Orlandogani/pers-esp32-headset/README.txt

This project is for custom headset Electronics PCB Routing. The name is coming from the acronym of my own name.

ORGA: Omni Radiant Gaming Apparatus
Vibe & Product Fit: Flagship RGB peripherals—think high-end wireless mice and master-class headsets designed for professional esports athletes who demand absolute dominance.
