Orlandogani/pers-esp32-headset/mech/out/V0_report_A.md

# ORGA rev A — V0 check report

Generated by `src/build_all.py`. Geometry checked with OpenCascade in the build workspace.

## Interference (all printed parts + purchased envelopes, assembly pose)

**Zero unintended overlaps.** (Press-fit inserts and the antenna region inside the module are excluded on purpose.)

## Clearance: left outer shell to each envelope [mm]

| Envelope | Distance | Rule (≥ 0.5 FDM) |
|---|---|---|
| arm pivot screw | 0.00 | CHECK |
| J1 USB-C | 0.09 | intended back-stop (0.1) |
| J4 jack | 0.10 | intended back-stop (0.1) |
| SW3 wheel | 0.30 | OK (wheel slot gap ≥ 0.25) |
| PCB | 0.30 | OK (PCB pocket rule ≥ 0.3) |
| D7+D3 LEDs | 0.91 | OK |
| U2 module | 2.03 | OK |
| SW PWR | 2.47 | OK |
| SW MFB | 2.50 | OK |
| MK1 | 2.56 | OK |
| MK2 | 2.56 | OK |
| SW3 encoder body | 2.85 | OK |
| driver L | 7.12 | OK |
| driver L magnet | 10.68 | OK |

Cell swell envelope to right outer shell: **2.15 mm** · driver to PCB: **1.20 mm** (vent gap ≥ 1.0)

## Antenna keep-out (≥ 15 mm to metal)

| Metal item | Distance [mm] | Result |
|---|---|---|
| screw pcb 2 | 15.6 | OK |
| insert pcb 2 | 15.7 | OK |
| driver L magnet | 16.7 | OK |
| MK2 | 18.2 | OK |
| insert shell 1 | 20.5 | OK |
| screw shell 1 | 22.9 | OK |
| SW MFB | 28.3 | OK |
| SW3 encoder body | 38.4 | OK |

## Cup tilt vs arm (rotation about the arm pivot axis)

| Tilt [deg] | Worst overlap [mm³] |
|---|---|
| -7.0 | 0.00 |
| -3.5 | 0.00 |
| +3.5 | 0.00 |
| +7.0 | 0.00 |

## Assembly-motion checks (rev A.5)

Each part is moved along its real assembly path; the table gives the worst overlap with anything it meets (0 = free path).

**Close left shell onto frame + PCB (travel along the cup axis)**

| Distance to go / offset | Worst overlap [mm³] | Between |
|---|---|---|
| 22 | 0.00 | — |
| 16 | 0.00 | — |
| 11 | 0.00 | — |
| 7 | 0.00 | — |
| 4 | 0.00 | — |
| 2 | 0.00 | — |
| 1 | 0.00 | — |
| 0.3 | 0.00 | — |

**Close right shell onto frame + driver + cell**

| Distance to go / offset | Worst overlap [mm³] | Between |
|---|---|---|
| 22 | 0.00 | — |
| 16 | 0.00 | — |
| 11 | 0.00 | — |
| 7 | 0.00 | — |
| 4 | 0.00 | — |
| 2 | 0.00 | — |
| 1 | 0.00 | — |
| 0.3 | 0.00 | — |

**Arm into the left shell tunnel (from the open side)**

| Distance to go / offset | Worst overlap [mm³] | Between |
|---|---|---|
| 25 | 0.00 | — |
| 18 | 0.00 | — |
| 12 | 0.00 | — |
| 8 | 0.00 | — |
| 5 | 0.00 | — |
| 3 | 0.00 | — |
| 1.5 | 0.00 | — |
| 0.5 | 0.00 | — |

**Pad ring into the skirt (snap: small overlap while the bumps pass is intended)**

| Distance to go / offset | Worst overlap [mm³] | Between |
|---|---|---|
| 7 | 0.00 | — |
| 5 | 0.00 | — |
| 4.6 | 1.69 | PADRING-L / CUPL-FRM |
| 4.2 | 5.72 | PADRING-L / CUPL-FRM |
| 3 | 5.93 | PADRING-L / CUPL-FRM |
| 2 | 5.93 | PADRING-L / CUPL-FRM |
| 1 | 5.16 | PADRING-L / CUPL-FRM |
| 0.3 | 0.00 | — |
| 0 | 0.00 | — |

**Slider in BAND-TOP (+ = pulled out; detent and stop contact expected)**

| Distance to go / offset | Worst overlap [mm³] | Between |
|---|---|---|
| 14 | 0.00 | — |
| 10 | 0.00 | — |
| 8 | 0.00 | — |
| 7 | 0.00 | — |
| 6.6 | 0.48 | SLIDER-L / BAND-TOP |
| 6.3 | 0.07 | SLIDER-L / BAND-TOP |
| 6.1 | 0.00 | — |
| 5.1 | 0.48 | SLIDER-L / BAND-TOP |
| 4.1 | 0.00 | — |
| 3 | 0.48 | SLIDER-L / BAND-TOP |
| 2 | 0.00 | — |
| 1 | 0.48 | SLIDER-L / BAND-TOP |
| 0 | 0.00 | — |
| -1 | 0.48 | SLIDER-L / BAND-TOP |
| -2 | 0.00 | — |
| -4.1 | 0.00 | — |
| -6.1 | 0.00 | — |

**Tool access**

| Tool path | Overlap [mm³] | Min clearance [mm] |
|---|---|---|
| shell screw 1: Ø3 bit from the ear side | 0.00 | 0.70 |
| shell screw 2: Ø3 bit from the ear side | 0.00 | 0.70 |
| shell screw 3: Ø3 bit from the ear side | 0.00 | 0.70 |
| shell screw 4: Ø3 bit from the ear side | 0.00 | 0.70 |
| PCB screw 1: Ø3 bit from above | 0.00 | 4.95 |
| PCB screw 2: Ø3 bit from above | 0.00 | 9.96 |
| PCB screw 3: Ø3 bit from above | 0.00 | 10.85 |
| arm pivot screw: Ø6 driver from outside | 0.00 | 0.78 |
| pivot nut: Ø6 tweezers along the screw axis from the cavity | 0.00 | 0.32 |

## Mass (PETG 1.27 g/cm³ × 0.9 fill; bought parts assumed)

| Item | g |
|---|---|
| CUPL-OUT | 34.4 |
| CUPL-FRM | 24.1 |
| CUPR-OUT | 34.9 |
| CUPR-FRM | 26.3 |
| PADRING-L | 6.0 |
| PADRING-R | 6.0 |
| KEY-PWR | 0.1 |
| KEY-MFB | 0.1 |
| LGUIDE | 0.2 |
| ARM-L | 4.2 |
| ARM-R | 4.2 |
| SLIDER-L | 3.7 |
| SLIDER-R | 3.7 |
| BAND-TOP | 35.4 |
| driver L (bought) | 12 |
| driver R (bought) | 12 |
| PCB assembly (bought) | 10 |
| cell 603450 (bought) | 20 |
| ear pad L (bought) | 12.5 |
| ear pad R (bought) | 12.5 |
| steel band 175x12x1 (bought) | 16.5 |
| screws + inserts (bought) | 3 |
| screws + inserts R (bought) | 2 |
| harness (bought) | 5 |
| cushion foam (bought) | 5 |

**Left cup 110 g · right cup 122 g · headband 62 g · total 294 g** (MR-001 ≤ 300: OK; MR-002 L/R Δ 11 g ≤ 40: OK)

## Print bed fit (256 × 256 × 256)

| Part | Print bbox [mm] | Fits |
|---|---|---|
| CUPL-OUT | 78 × 105 × 22 | yes |
| CUPL-FRM | 78 × 105 × 29 | yes |
| CUPR-OUT | 78 × 105 × 22 | yes |
| CUPR-FRM | 78 × 105 × 31 | yes |
| PADRING-L | 80 × 107 × 8 | yes |
| PADRING-R | 80 × 107 × 8 | yes |
| KEY-PWR | 8 × 4 × 6 | yes |
| KEY-MFB | 8 × 4 × 6 | yes |
| LGUIDE | 4 × 7 × 8 | yes |
| ARM-L | 41 × 84 × 8 | yes |
| ARM-R | 41 × 84 × 8 | yes |
| SLIDER-L | 60 × 67 × 12 | yes |
| SLIDER-R | 60 × 67 × 12 | yes |
| BAND-TOP | 190 × 42 × 26 | yes |

## Edge-part alignment

Shell openings are generated from the same layout table as the PCB change list, so offsets are 0.0 mm by construction. The real check runs when the updated KiCad board STEP comes back (file 09 round-trip).
