Orlandogani/pers-esp32-headset/mech/out/V0_report_B.md

# ORGA rev B — V0 check report

Generated by `src/build_all.py`. Geometry checked with OpenCascade in the build workspace.

## Interference (all printed parts + purchased envelopes, assembly pose)

**Zero unintended overlaps.** (Press-fit inserts and the antenna region inside the module are excluded on purpose.)

## Clearance: left outer shell to each envelope [mm]

| Envelope | Distance | Rule (≥ 0.5 FDM) |
|---|---|---|
| J1 USB-C | 0.09 | intended back-stop (0.1) |
| J4 jack | 0.10 | intended back-stop (0.1) |
| SW3 wheel | 0.30 | OK (wheel slot gap ≥ 0.25) |
| PCB | 0.30 | OK (PCB pocket rule ≥ 0.3) |
| D7+D3 LEDs | 0.91 | OK |
| U2 module | 2.03 | OK |
| SW PWR | 2.47 | OK |
| SW MFB | 2.50 | OK |
| MK1 | 2.56 | OK |
| MK2 | 2.56 | OK |
| SW3 encoder body | 2.85 | OK |
| driver L | 8.48 | OK |
| driver L magnet | 10.68 | OK |

Cell swell envelope to right outer shell: **2.15 mm** · driver to PCB: **1.20 mm** (vent gap ≥ 1.0)

## Antenna keep-out (≥ 15 mm to metal)

| Metal item | Distance [mm] | Result |
|---|---|---|
| screw pcb 2 | 15.6 | OK |
| insert pcb 2 | 15.7 | OK |
| driver L magnet | 16.7 | OK |
| MK2 | 18.2 | OK |
| insert shell 1 | 20.5 | OK |
| screw shell 1 | 22.9 | OK |
| SW MFB | 28.3 | OK |
| SW3 encoder body | 38.4 | OK |

## Cup tilt vs yoke (rotation about the stud axis)

Doc 06 asks ±10° free. Contact past ±12° is the intended hard stop (stud lug in the yoke-end arc slot).

| Tilt [deg] | Worst overlap [mm³] |
|---|---|
| -14.0 | 6.43 |
| -12.5 | 0.18 |
| -11.5 | 0.00 |
| -10.0 | 0.00 |
| -5.0 | 0.00 |
| +5.0 | 0.00 |
| +10.0 | 0.00 |
| +11.5 | 0.00 |
| +12.5 | 0.18 |
| +14.0 | 0.71 |

## Swivel (yaw) vs slider collar and S-arm

| Yaw [deg] | Worst overlap [mm³] | Between |
|---|---|---|
| -15.0 | 0.00 | — |
| -7.5 | 0.00 | — |
| +7.5 | 0.00 | — |
| +15.0 | 0.00 | — |

## Yoke snap-on (hand calculation, PETG E ≈ 2 GPa)

Each end spreads **4.4 mm** to pass its stud: ≈ **4.4 N** per end, peak bending stress ≈ **13 MPa** (PETG yield ≈ 50 MPa). VERIFY on the first print.

## Assembly-motion checks (rev B)

Each part is moved along its real assembly path; the table gives the worst overlap with anything it meets (0 = free path).

**Close left shell onto frame + PCB (travel along the cup axis)**

| Distance to go / offset | Worst overlap [mm³] | Between |
|---|---|---|
| 22 | 0.00 | — |
| 16 | 0.00 | — |
| 11 | 0.00 | — |
| 7 | 0.00 | — |
| 4 | 0.00 | — |
| 2 | 0.00 | — |
| 1 | 0.00 | — |
| 0.3 | 0.00 | — |

**Close right shell onto frame + driver + cell**

| Distance to go / offset | Worst overlap [mm³] | Between |
|---|---|---|
| 22 | 0.00 | — |
| 16 | 0.00 | — |
| 11 | 0.00 | — |
| 7 | 0.00 | — |
| 4 | 0.00 | — |
| 2 | 0.00 | — |
| 1 | 0.00 | — |
| 0.3 | 0.00 | — |

**Yoke lowered onto the closed left cup: everything except the stud zones (the ends spread 4.4 mm over the studs, see snap calc)**

| Distance to go / offset | Worst overlap [mm³] | Between |
|---|---|---|
| 8 | 0.00 | — |
| 5 | 0.00 | — |
| 3 | 0.00 | — |
| 1.5 | 0.00 | — |
| 0.5 | 0.00 | — |
| 0 | 0.00 | — |

**Slider collar down over the yoke's swivel pin**

| Distance to go / offset | Worst overlap [mm³] | Between |
|---|---|---|
| 8 | 0.00 | — |
| 5 | 0.00 | — |
| 3 | 0.00 | — |
| 1 | 0.00 | — |
| 0.3 | 0.00 | — |
| 0 | 0.00 | — |

**Pad ring into the skirt (snap: small overlap while the bumps pass is intended)**

| Distance to go / offset | Worst overlap [mm³] | Between |
|---|---|---|
| 7 | 0.00 | — |
| 5 | 0.00 | — |
| 4.6 | 1.69 | PADRING-L / CUPL-FRM |
| 4.2 | 5.72 | PADRING-L / CUPL-FRM |
| 3 | 5.93 | PADRING-L / CUPL-FRM |
| 2 | 5.93 | PADRING-L / CUPL-FRM |
| 1 | 5.16 | PADRING-L / CUPL-FRM |
| 0.3 | 0.00 | — |
| 0 | 0.00 | — |

**Slider in BAND-TOP (+ = pulled out; detent and stop contact expected)**

| Distance to go / offset | Worst overlap [mm³] | Between |
|---|---|---|
| 14 | 0.00 | — |
| 10 | 0.00 | — |
| 8 | 0.00 | — |
| 7 | 0.00 | — |
| 6.6 | 0.48 | SLIDER-L / BAND-TOP |
| 6.3 | 0.07 | SLIDER-L / BAND-TOP |
| 6.1 | 0.00 | — |
| 5.1 | 0.48 | SLIDER-L / BAND-TOP |
| 4.1 | 0.00 | — |
| 3 | 0.48 | SLIDER-L / BAND-TOP |
| 2 | 0.00 | — |
| 1 | 0.48 | SLIDER-L / BAND-TOP |
| 0 | 0.00 | — |
| -1 | 0.48 | SLIDER-L / BAND-TOP |
| -2 | 0.00 | — |
| -4.1 | 0.00 | — |
| -6.1 | 0.00 | — |

**Tool access**

| Tool path | Overlap [mm³] | Min clearance [mm] |
|---|---|---|
| shell screw 1: Ø3 bit from the ear side | 0.00 | 0.70 |
| shell screw 2: Ø3 bit from the ear side | 0.00 | 0.70 |
| shell screw 3: Ø3 bit from the ear side | 0.00 | 0.70 |
| shell screw 4: Ø3 bit from the ear side | 0.00 | 0.70 |
| PCB screw 1: Ø3 bit from above | 0.00 | 4.95 |
| PCB screw 2: Ø3 bit from above | 0.00 | 9.96 |
| PCB screw 3: Ø3 bit from above | 0.00 | 10.85 |
| collar set screw: Ø3 bit from the -X_H side | 0.00 | 0.30 |

## Mass (PETG 1.27 g/cm³ × 0.9 fill; bought parts assumed)

| Item | g |
|---|---|
| CUPL-OUT | 31.0 |
| CUPL-FRM | 24.3 |
| CUPR-OUT | 31.5 |
| CUPR-FRM | 26.5 |
| PADRING-L | 6.0 |
| PADRING-R | 6.0 |
| KEY-PWR | 0.1 |
| KEY-MFB | 0.1 |
| LGUIDE | 0.2 |
| YOKE-L | 6.6 |
| YOKE-R | 6.6 |
| SLIDER-L | 4.8 |
| SLIDER-R | 4.8 |
| BAND-TOP | 35.4 |
| driver L (bought) | 12 |
| driver R (bought) | 12 |
| PCB assembly (bought) | 10 |
| cell 603450 (bought) | 20 |
| ear pad L (bought) | 12.5 |
| ear pad R (bought) | 12.5 |
| steel band 175x12x1 (bought) | 16.5 |
| screws + inserts (bought) | 3 |
| screws + inserts R (bought) | 2 |
| harness (bought) | 5 |
| cushion foam (bought) | 5 |

**Left cup 111 g · right cup 122 g · headband 62 g · total 294 g** (MR-001 ≤ 300: OK; MR-002 L/R Δ 11 g ≤ 40: OK)

## Print bed fit (256 × 256 × 256)

| Part | Print bbox [mm] | Fits |
|---|---|---|
| CUPL-OUT | 86 × 105 × 22 | yes |
| CUPL-FRM | 78 × 105 × 29 | yes |
| CUPR-OUT | 86 × 105 × 22 | yes |
| CUPR-FRM | 78 × 105 × 31 | yes |
| PADRING-L | 80 × 107 × 8 | yes |
| PADRING-R | 80 × 107 × 8 | yes |
| KEY-PWR | 8 × 4 × 6 | yes |
| KEY-MFB | 8 × 4 × 6 | yes |
| LGUIDE | 4 × 7 × 8 | yes |
| YOKE-L | 86 × 73 × 13 | yes |
| YOKE-R | 86 × 73 × 13 | yes |
| SLIDER-L | 60 × 80 × 12 | yes |
| SLIDER-R | 60 × 80 × 12 | yes |
| BAND-TOP | 190 × 42 × 26 | yes |

## Edge-part alignment

Shell openings are generated from the same layout table as the PCB change list, so offsets are 0.0 mm by construction. The real check runs when the updated KiCad board STEP comes back (file 09 round-trip).
