Orlandogani/pers-esp32-headset/mech/log.md

# Mechanical iteration log

| Date | Rev | Change | Print / result |
|---|---|---|---|
| 2026-10-08 | baseline | MDCP v0.1 issued; board envelope from orga-v1 placement | — |
| 2026-10-09 | concept v0 | Decisions: M1-A (components face outer shell), concept C2 (cell in right cup, 5-wire harness). Yoke: plastic fork (confirmed). New issues I-12 (board outline must follow cavity; antenna to magnet) and I-13 (95th-pct ear clearance). Sony WH-1000XM5 reference STEP checked: exterior-only model. | concepts/report.txt, renders/ORGA-concept-C*.png |
| 2026-10-09 | A | Rev A fit-test build: 15 printed parts (cups L/R outer + frame, pad rings, keys, wheel, light guide, forks, sliders, band top). V0: 0 interferences, clearances OK, antenna >= 17.5 mm, tilt +/-10 deg clear, all parts fit 256 bed. Mass est. 301 g (MR-001 at limit, bought masses assumed). PCB package: out/ORGA-PCB-outline-A.dxf + out/PCB_changes_A.md. | out/V0_report_A.md, renders/ORGA-M-*-A_*.png |
| 2026-10-09 | A.1 | FORK-L/R changed from rectangular to an oval arch following the cup outline (same superellipse, 6 x 7 mm section, harness channel along the rear arm). Rechecked in FreeCAD via MCP: 0 interferences, tilt +/-10 deg clear. Fork 10.7 -> 8.7 g each; total est. 297 g (MR-001 now OK). | renders/ORGA-M-ASM-A1_freecad_*.png |
| 2026-10-09 | A.2 | All edge parts moved to the lower half of the rim (front->rear: jack, POWER, USB-C, wheel, MFB), all sitting directly on the PCB, openings in one band 0.7-2.5 mm above the board. Thumbwheel = Panasonic EVQ-WK edge-drive (Ø15, H 3.5, VERIFY availability); printed WHEEL part removed (moved to out/_obsolete). Lower shell screws moved to rim gaps; MK1 to (-17,-35). Built in workspace, checked in FreeCAD via MCP: 0 interferences, wheel slot gap 0.3, antenna >= 17.5. Mass est. 296 g. | renders/ORGA-M-CUPL-A2_freecad_*.png, out/PCB_changes_A.md |
| 2026-10-09 | A.3 | Fork replaced by a Sony-style single arm (own geometry, not the Sony part): arm enters the top-front rim and runs down a sealed tunnel along the front wall to a tilt pivot at cup centre height (M3 shoulder screw through the front wall into an insert). Tilt +/-7 deg (doc asks 10, VERIFY on head). ESP32 module rotated 90 deg, antenna at the REAR board edge (X=33); LED, MK2, PCB holes 2-3 and upper shell screws moved. Driver frame now assumed plastic, magnet metal (VERIFY). Checked in FreeCAD via MCP: 0 interferences, tilt +/-7 clear, antenna >= 15.6 mm. Mass est. 295 g. Old fork files in out/_obsolete. | renders/ORGA-M-A3_freecad_*.png, out/PCB_changes_A.md |
| 2026-10-09 | A.4 | Assembly pass. Fixes: USB-C and wheel openings now notches open at the shell bottom edge + frame tabs fill them (shell could not be lowered over the PCB); arm tunnel open to the frame (arm drops in; baffle + foam strip = floor); arm notch open at bottom; pivot = ISO 7379 shoulder screw into a pressed M3 nut (nut trap, boss 3.2); PADRING with 6 snap bumps on slit tabs + skirt groove + pry notch, pad sleeve wraps the lip; slider detent with square pull-out stop at +15.7 mm and tip lead-in; arc groove on swivel pin = +/-15 deg yaw stop; Ø2 cross pin closes the steel-band slot; harness grooves on arm, socket, slider. New assembly-motion + tool-access checks all pass (also re-checked shell path and interference in FreeCAD via MCP). Guide: docs/ASSEMBLY.md + renders/ORGA-guide-*.png. Mass est. 294 g. | out/V0_report_A.md |
| 2026-10-10 | A.5 | Routing-chat changes: SW3 = SIQ-02FVS3 (dial Ø14.4, top 4.0 above board; dial t 2.5 / body 1.5 assumed-VERIFY, body 11.1 x 10); PCB tab under the dial 8 mm wide to 4.0 past the dial centre along -62° (ends 0.3 into the wall notch, 3.3 to the notch sides); frame wheel plug pocketed for the tab (0.3 gap, open upward); H1 moved (7,-42) -> (0,-37) (standoff 3.6 to J1, screw-1 tool clearance 4.95). All V0 + assembly-motion checks pass, 0 interferences, mass 294 g. | out/V0_report_A.md, out/PCB_changes_A.md, out/ORGA-PCB-outline-A.dxf |
| 2026-10-13 | B | HS35-style mechanism (own geometry), from the routing chat. The tunnel arm is replaced by a horseshoe YOKE outside the upper half of the cup: plastic snap studs front + rear at y=0 (no metal near the antenna), tilt ±10° free with a hard stop at ±12° (stud lug in an arc slot), swivel collar at the yoke crown (±15°), and an S-arm at the slider end. Harness runs as a free loop to a grommet hole in the outer face. Cap-disc ring groove Ø56 on the outer face. Tunnel, pivot screw and nut removed; board outline +487 mm² along the front-upper wall, edge parts and holes unchanged. Yoke proud 4.1 / 6.1 mm (a flush yoke would need U2 moved ~4 mm). V0: 0 interferences, tilt/yaw/assembly sweeps clear, antenna ≥ 16.7 mm, mass 294 g. | out/V0_report_B.md, renders/ORGA-M-CUPL-B_*.png, out/ORGA-PCB-outline-B.dxf |
