Orlandogani/pers-esp32-headset/mech/renders/ORGA-concept-C1.png

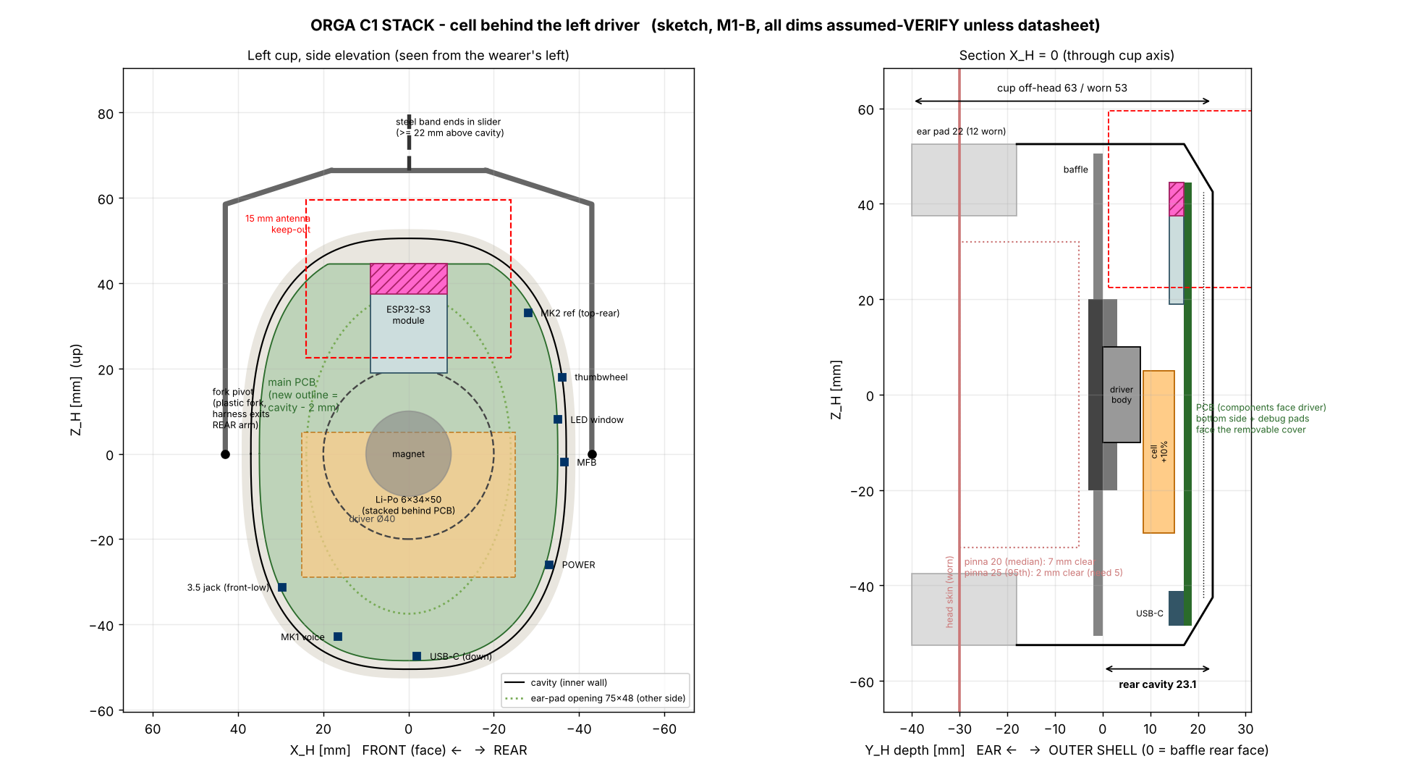
mech/renders/ORGA-concept-C1.png
