Orlandogani/pers-esp32-headset/mech/renders/ORGA-M-A3_freecad_front.png

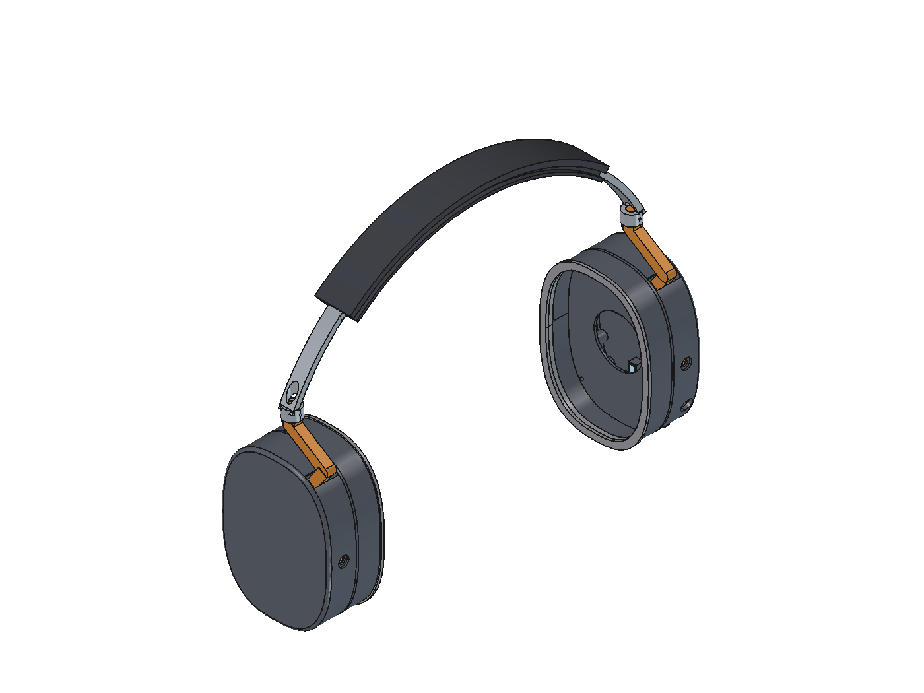
mech/renders/ORGA-M-A3_freecad_front.png
