Orlandogani/pers-esp32-headset/mech/renders/ORGA-M-A3_freecad_xray.png

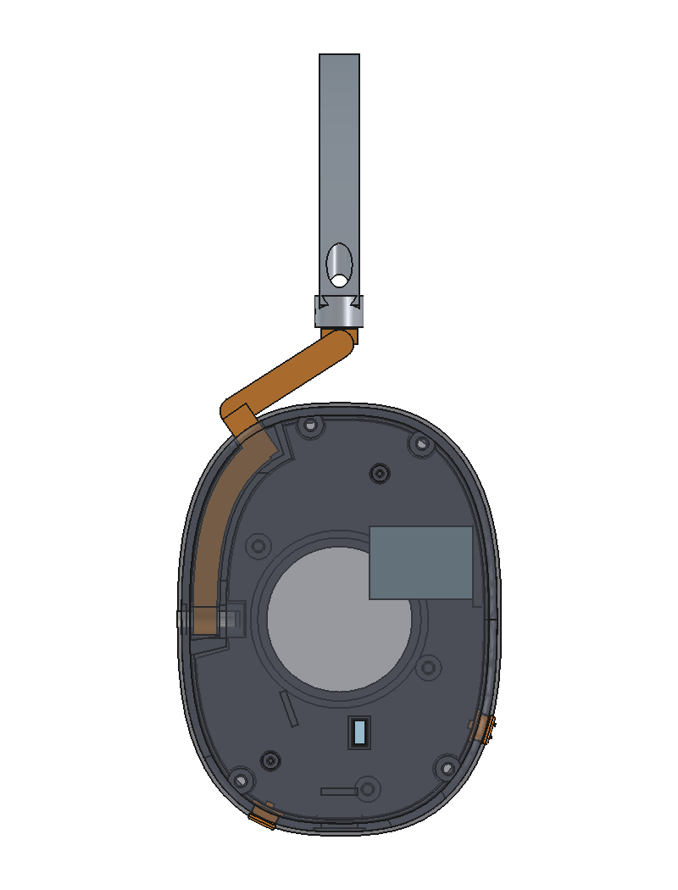
mech/renders/ORGA-M-A3_freecad_xray.png
