Orlandogani/pers-esp32-headset/mech/renders/ORGA-M-A4_freecad_iso.png

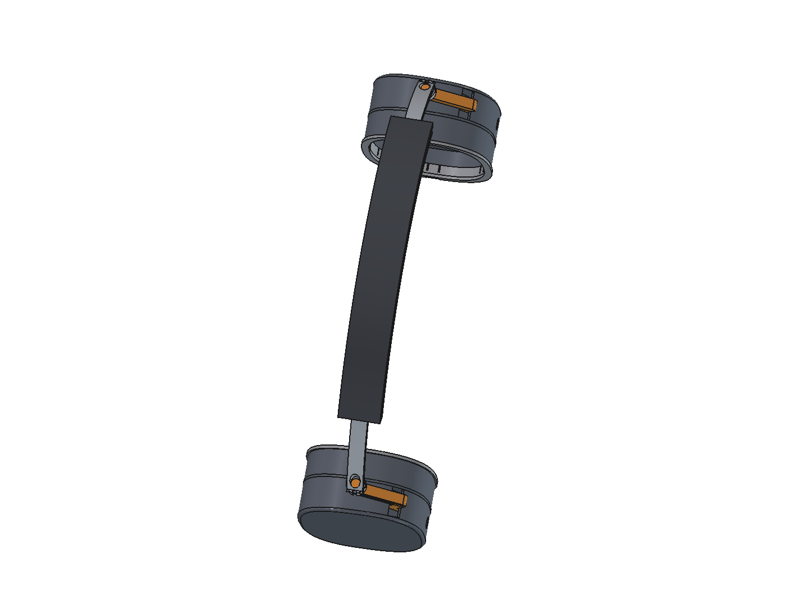
mech/renders/ORGA-M-A4_freecad_iso.png
