Orlandogani/pers-esp32-headset/mech/renders/ORGA-M-ASM-A1_freecad_iso.png

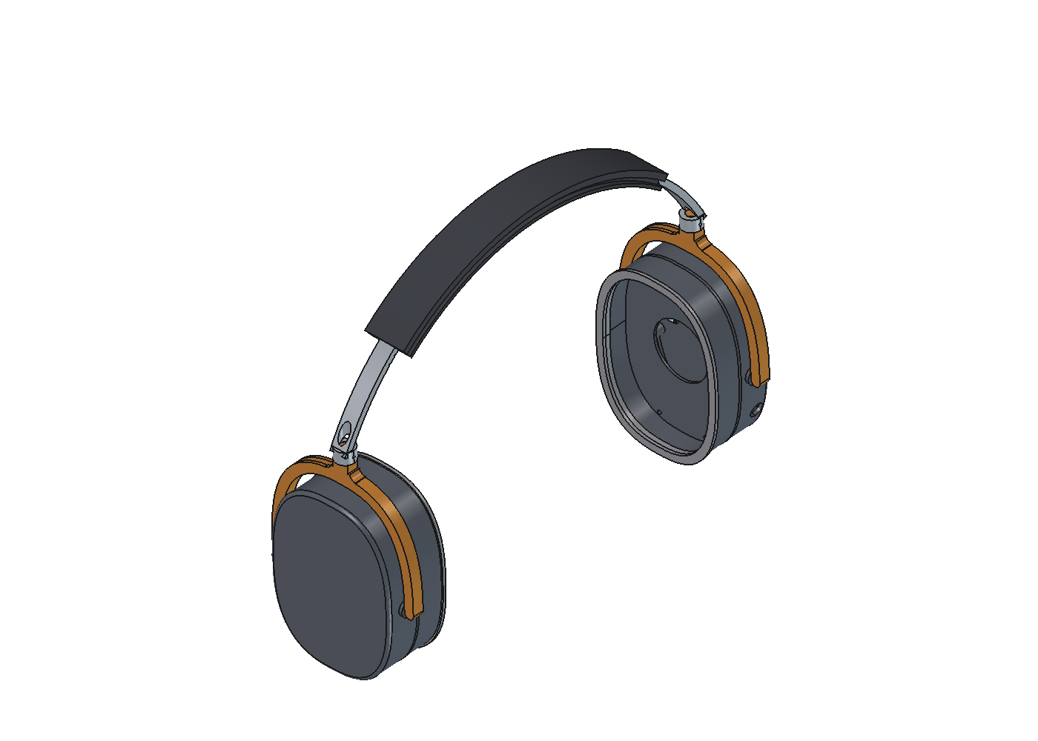
mech/renders/ORGA-M-ASM-A1_freecad_iso.png
