Orlandogani/pers-esp32-headset/mech/renders/ORGA-M-ASM-A1_freecad_side.png

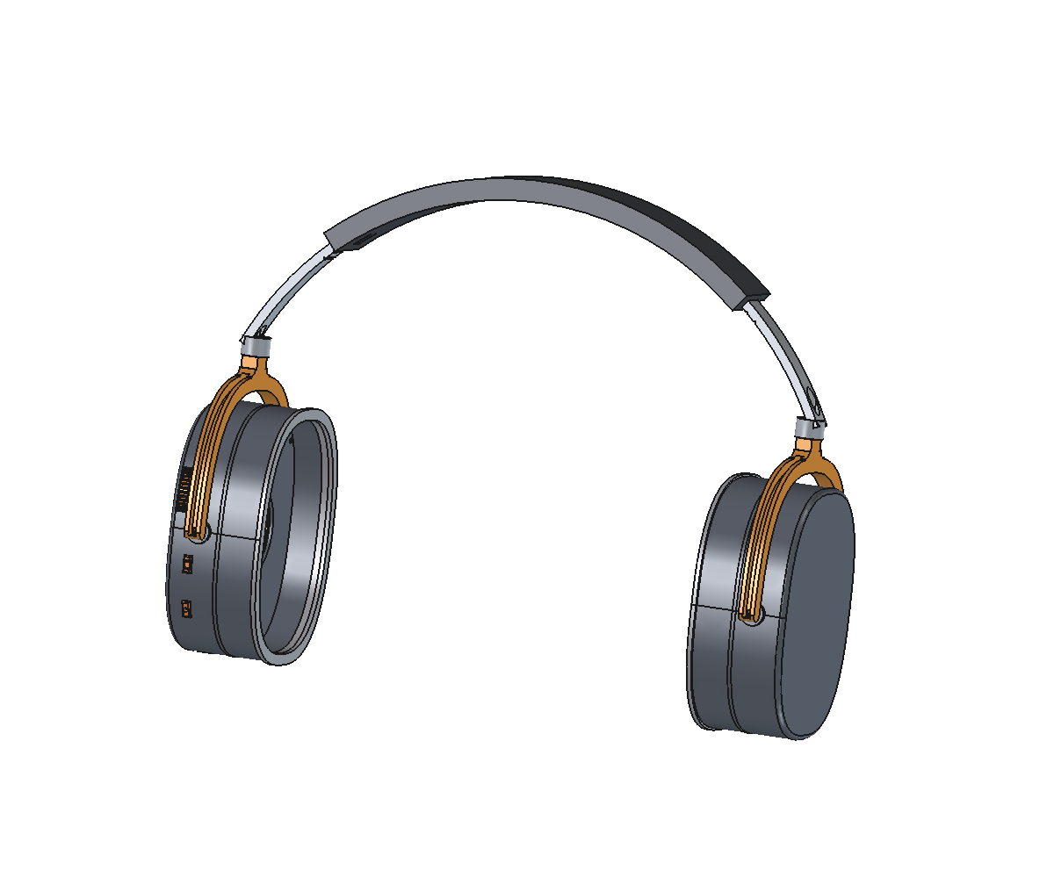
mech/renders/ORGA-M-ASM-A1_freecad_side.png
