Orlandogani/pers-esp32-headset/mech/renders/ORGA-M-ASM-A2_freecad_iso.png

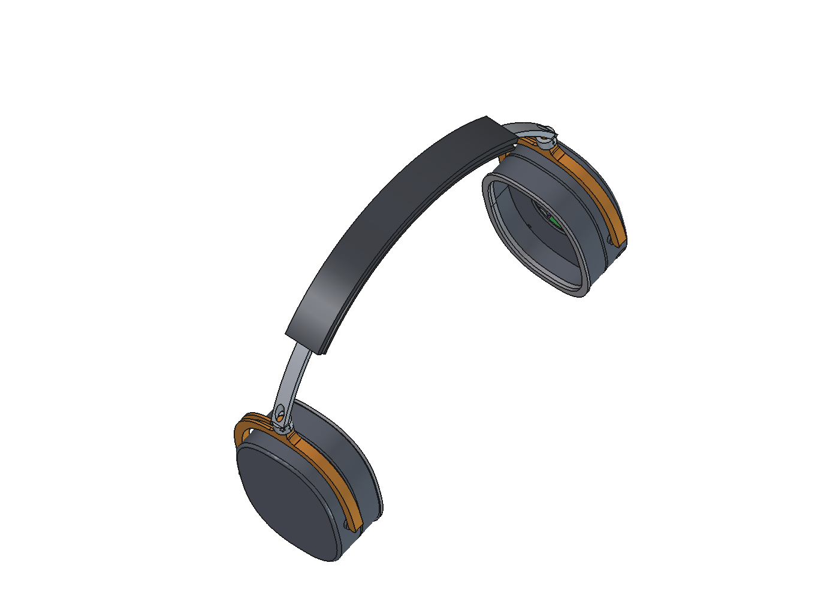
mech/renders/ORGA-M-ASM-A2_freecad_iso.png
