Orlandogani/pers-esp32-headset/mech/renders/ORGA-M-ASM-A_iso.png

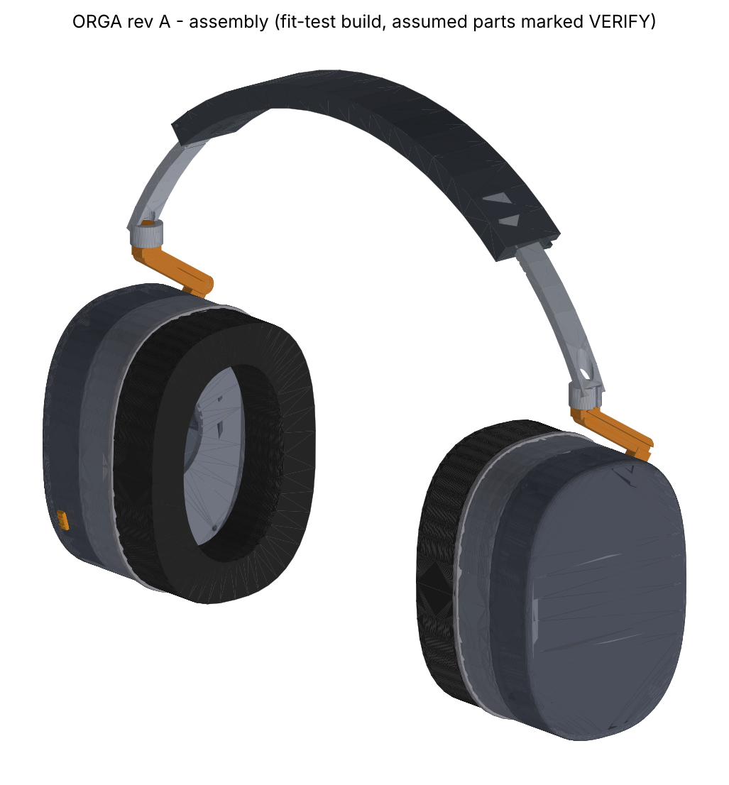
mech/renders/ORGA-M-ASM-A_iso.png
