Orlandogani/pers-esp32-headset/mech/renders/ORGA-M-ASM-B_iso.png

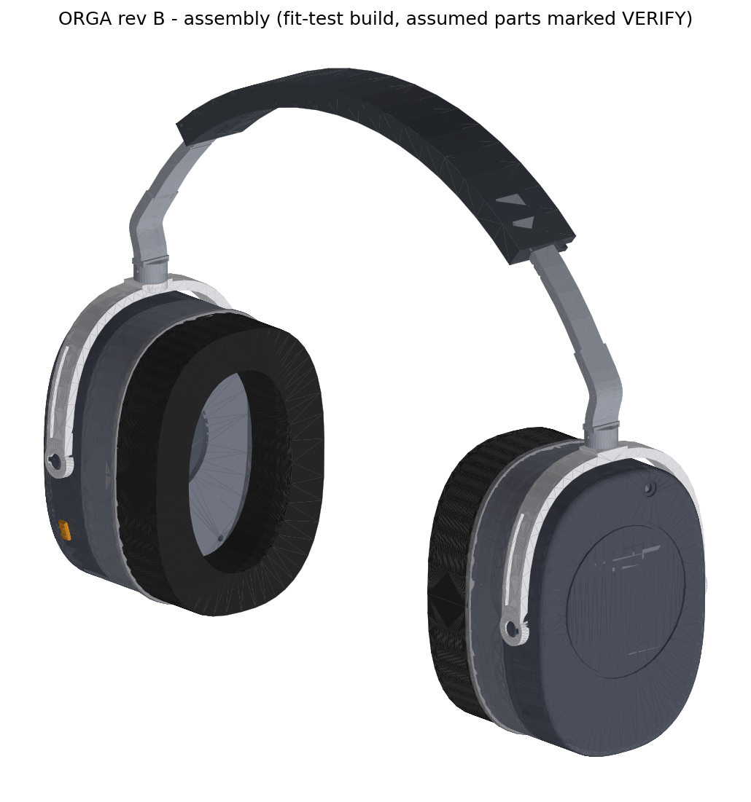
mech/renders/ORGA-M-ASM-B_iso.png
