Orlandogani/pers-esp32-headset/mech/renders/ORGA-M-CUPL-A2_freecad_below.png

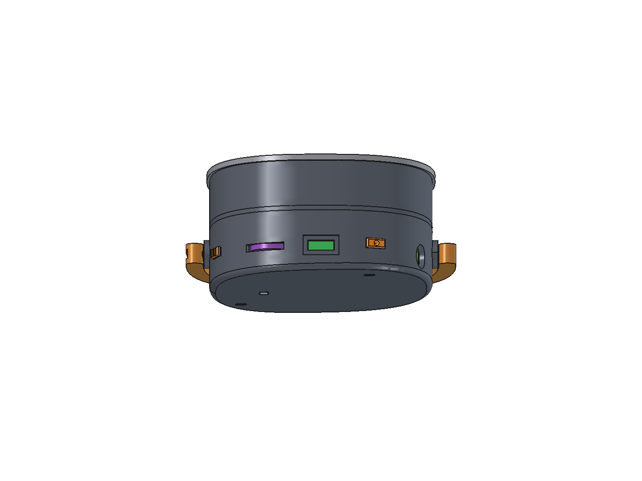
mech/renders/ORGA-M-CUPL-A2_freecad_below.png
