Orlandogani/pers-esp32-headset/mech/renders/ORGA-M-CUPL-A2_freecad_bottom.png

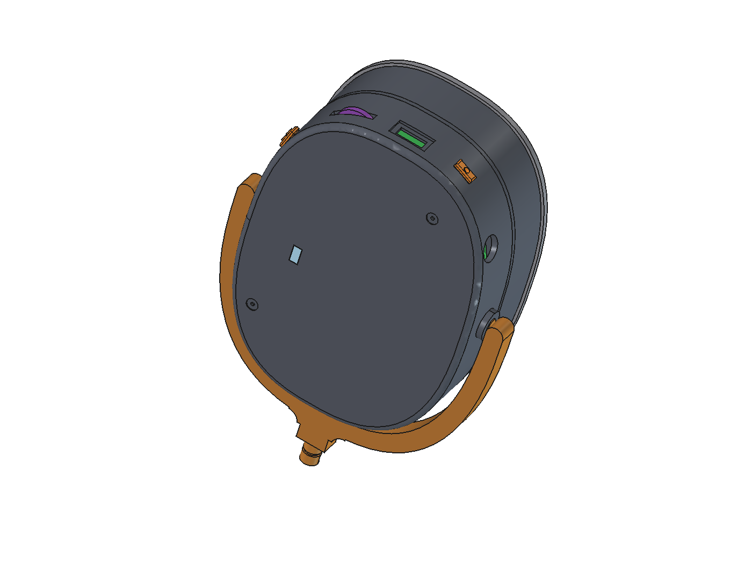
mech/renders/ORGA-M-CUPL-A2_freecad_bottom.png
