Orlandogani/pers-esp32-headset/mech/renders/ORGA-M-CUPL-A2_freecad_side.png

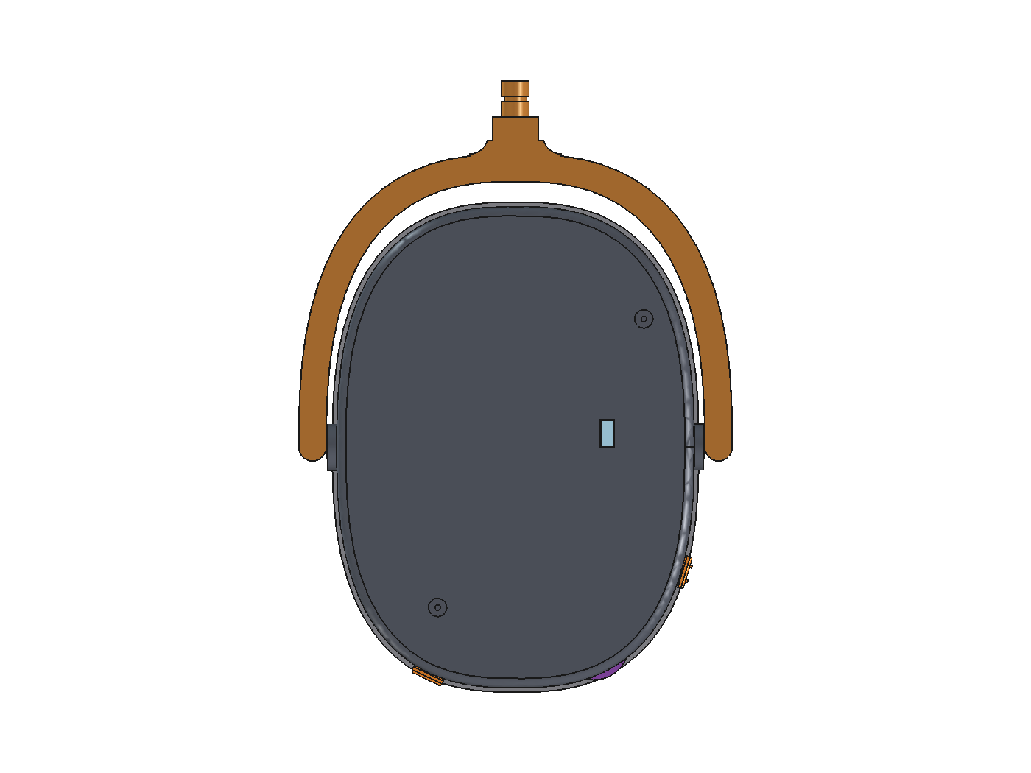
mech/renders/ORGA-M-CUPL-A2_freecad_side.png
