Orlandogani/pers-esp32-headset/mech/renders/ORGA-M-CUPL-A_exploded.png

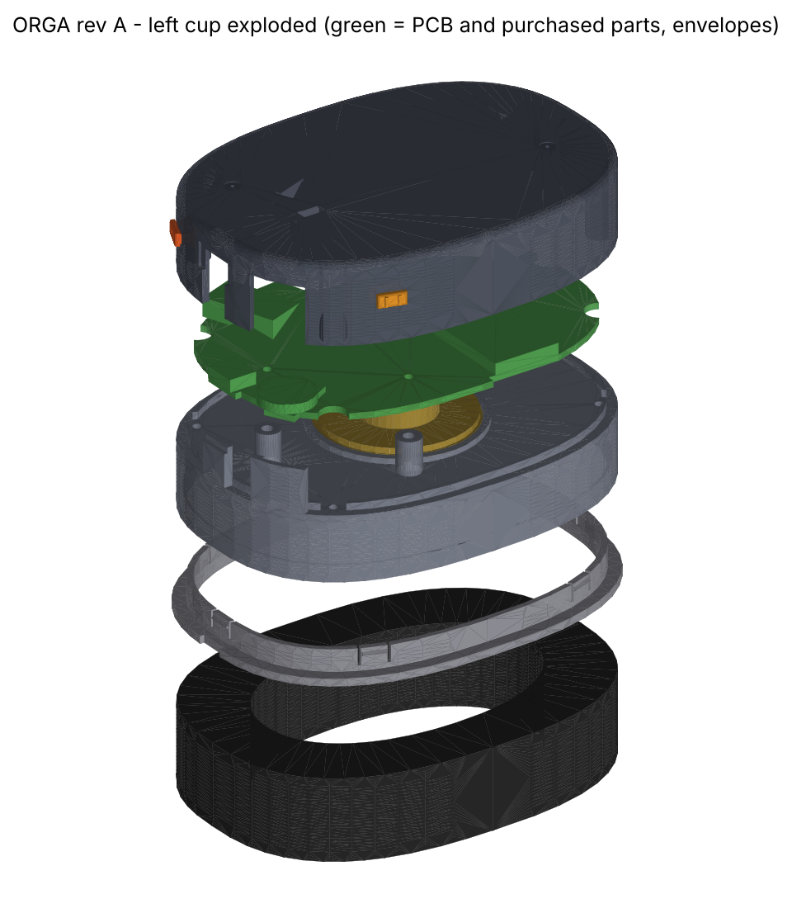
mech/renders/ORGA-M-CUPL-A_exploded.png
