Orlandogani/pers-esp32-headset/mech/renders/ORGA-M-CUPL-A_section.png

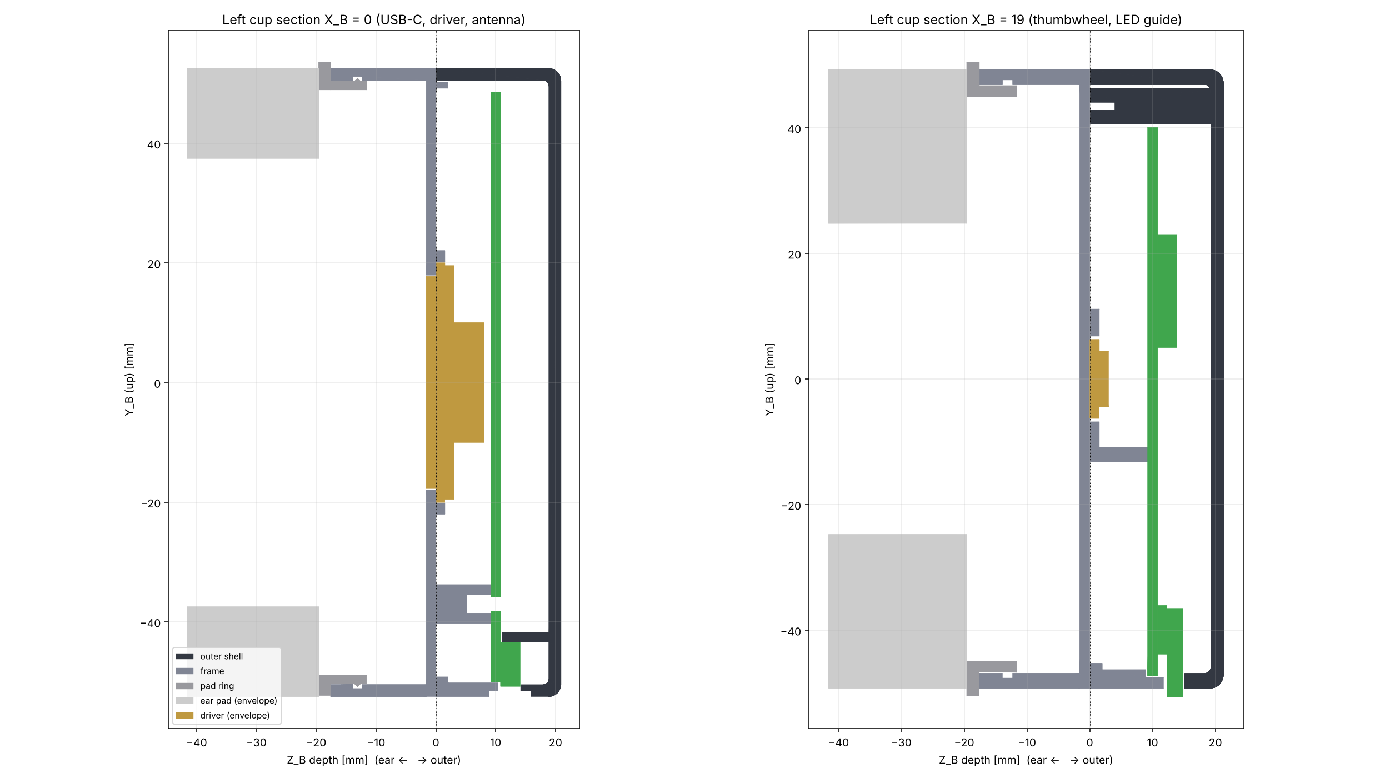
mech/renders/ORGA-M-CUPL-A_section.png
