Orlandogani/pers-esp32-headset/mech/renders/ORGA-M-CUPL-B_exploded.png

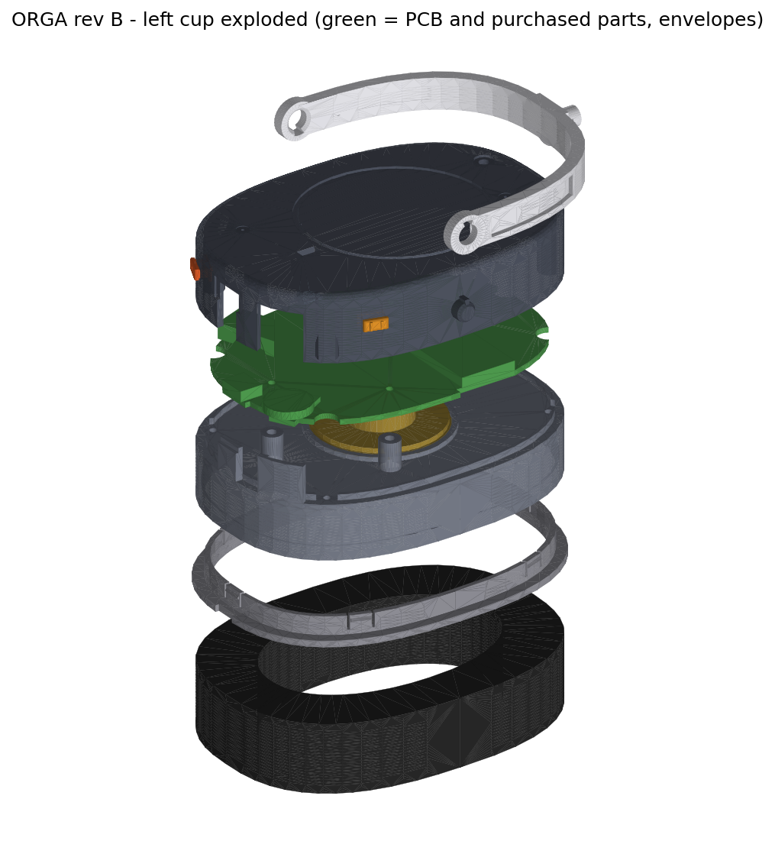
mech/renders/ORGA-M-CUPL-B_exploded.png
