Orlandogani/pers-esp32-headset/mech/renders/ORGA-M-CUPL-B_front.png

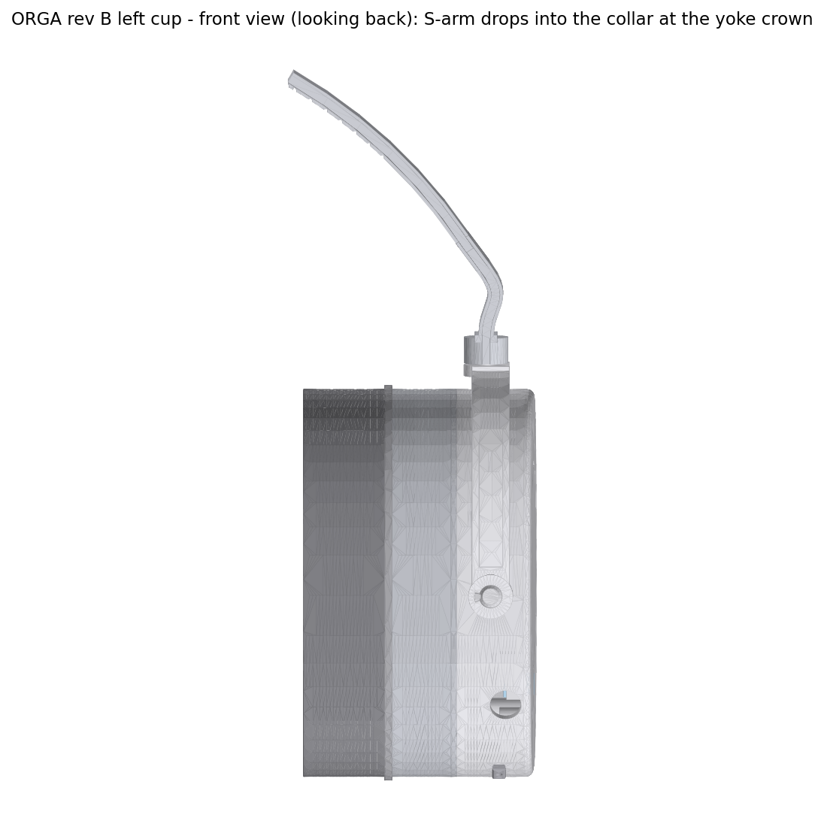
mech/renders/ORGA-M-CUPL-B_front.png
