Orlandogani/pers-esp32-headset/mech/renders/ORGA-M-CUPL-B_outer.png

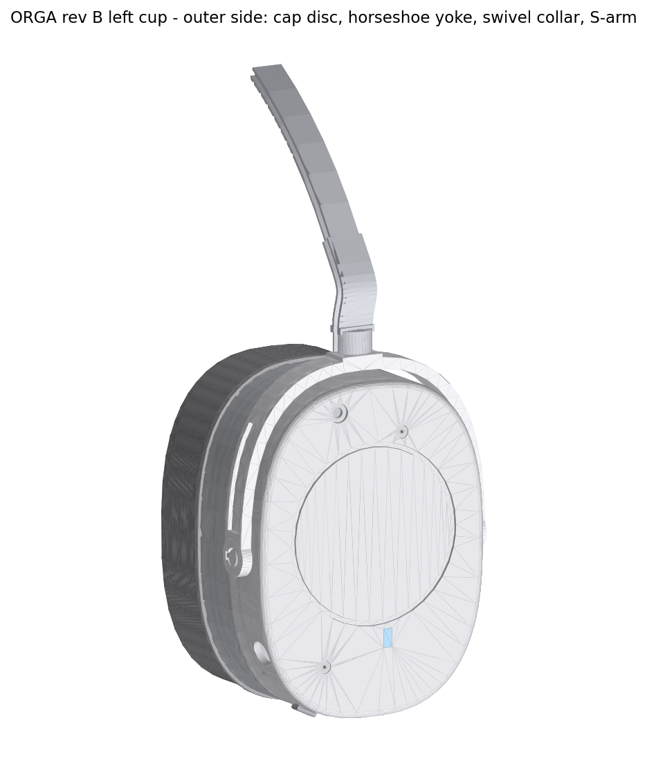
mech/renders/ORGA-M-CUPL-B_outer.png
