Orlandogani/pers-esp32-headset/mech/renders/ORGA-M-CUPL-B_section.png

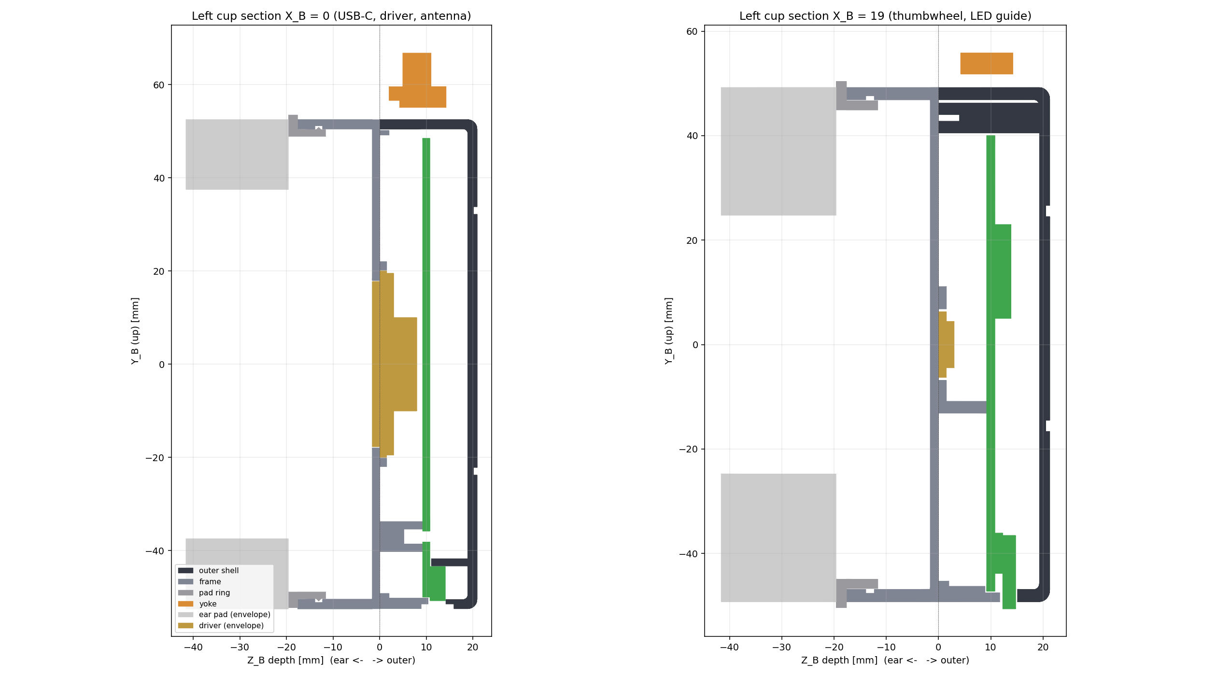
mech/renders/ORGA-M-CUPL-B_section.png
