Orlandogani/pers-esp32-headset/mech/renders/ORGA-M-CUPL-B_tilt12.png

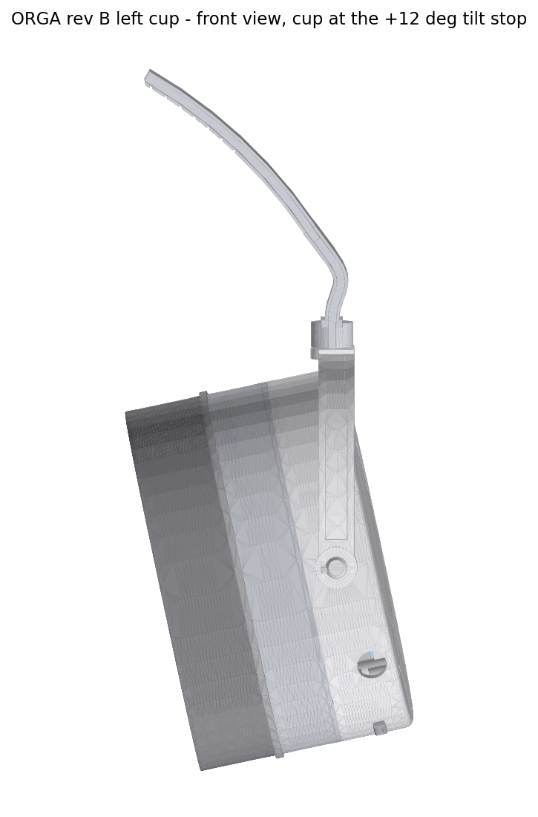
mech/renders/ORGA-M-CUPL-B_tilt12.png
