Orlandogani/pers-esp32-headset/mech/renders/orga_v1_mech_drawing.png

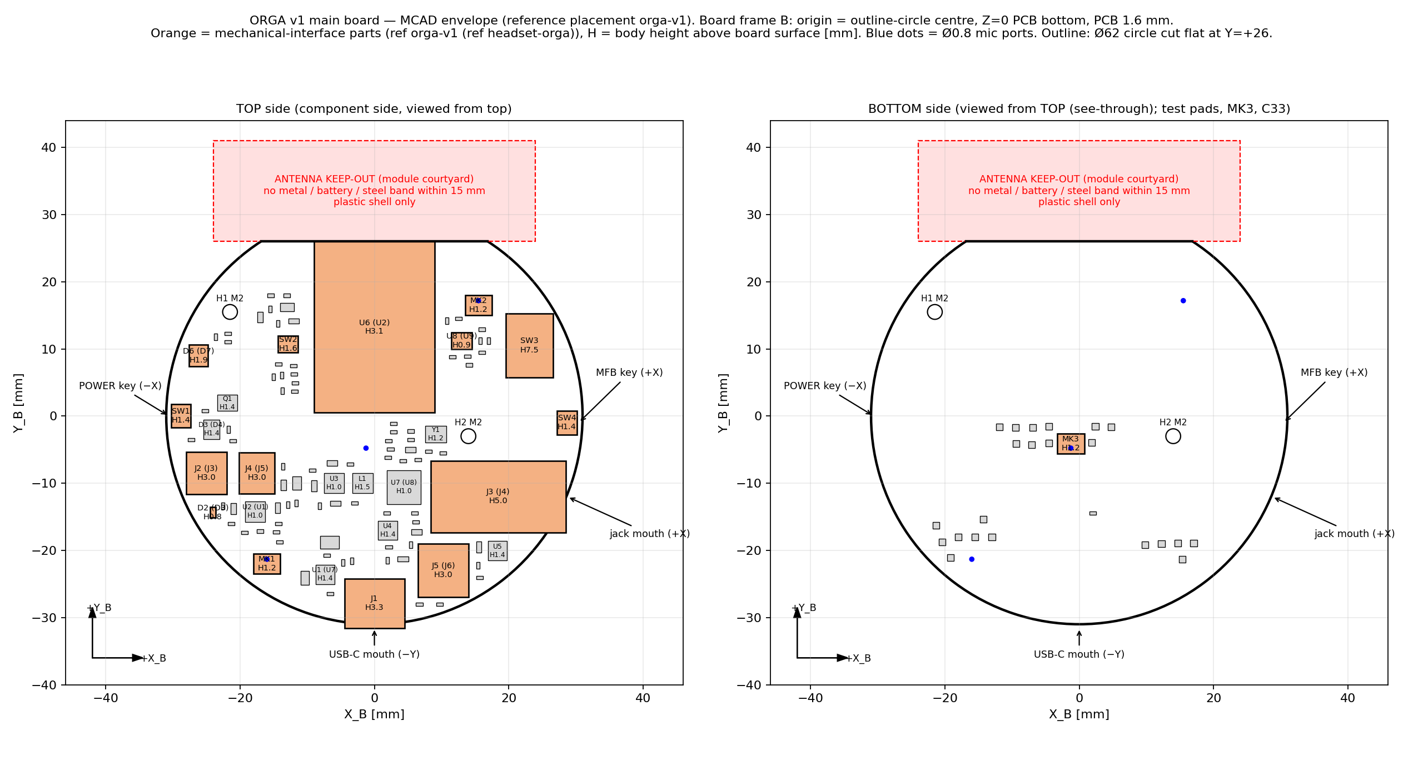
mech/renders/orga_v1_mech_drawing.png
