Orlandogani/pers-esp32-headset/mech/out/ORGA-M-parts-list-A.md

# ORGA rev A — parts list

## Printed (files in out/print, already oriented for the bed)

| Part | Qty | Material | Print note |
|---|---|---|---|
| ORGA-M-CUPL-OUT-A | 1 | PETG | outer face down, tree support under the R3 edge |
| ORGA-M-CUPL-FRM-A | 1 | PETG | skirt end down, support inside skirt for the baffle |
| ORGA-M-CUPR-OUT-A | 1 | PETG | mirror of the base shell |
| ORGA-M-CUPR-FRM-A | 1 | PETG | battery tray integrated |
| ORGA-M-PADRING-L-A | 1 | PETG | adapter for the bought ear pad (M7) |
| ORGA-M-PADRING-R-A | 1 | PETG |  |
| ORGA-M-KEY-PWR-A | 1 | PETG | cap face down |
| ORGA-M-KEY-MFB-A | 1 | PETG | cap face down |
| ORGA-M-LGUIDE-A | 1 | clear PETG / clear resin |  |
| ORGA-M-ARM-L-A | 1 | PETG | flat on the bed; small supports under the swivel pin |
| ORGA-M-ARM-R-A | 1 | PETG |  |
| ORGA-M-SLIDER-L-A | 1 | PETG | on its side |
| ORGA-M-SLIDER-R-A | 1 | PETG | on its side |
| ORGA-M-BAND-TOP-A | 1 | PETG | on its side; steel band slides in from the +Y end |

## Hardware and bought parts

| Item | Qty | Spec | Status |
|---|---|---|---|
| M2 heat-set insert | 11 | brass, OD ≈3.6, L 4 (hole Ø3.2 × 4): 4 per shell + 3 in the left frame | standard |
| M2 × 5 screw | 8 | pan/button head, shell to frame (from the ear side, under the pad) | standard |
| M2 × 4 screw | 3 | PCB to standoffs | standard |
| M2 × 4 self-tapping | 2 | slider set screw: rides in the arc groove of the swivel pin (retention + ±15° yaw stop) | standard |
| M3 shoulder screw | 2 | ISO 7379, shoulder Ø4 × 8, M3 thread — arm tilt pivot | VERIFY thread length |
| M3 hex nut | 2 | ISO 4032, pressed into the nut trap inside each cup | standard |
| Ø2 × 14 pin | 1 | dowel or M2 × 14 screw, closes the steel-band slot | standard |
| Foam strip | 2 | 1 mm closed-cell, along the tunnel floor on the baffle (seals tunnel from the cavity) | buy |
| Driver gasket | 2 | closed-cell foam ring, Ø44 / Ø37 × 1 mm | buy |
| Spring-steel band | 1 | 171 × 12 × 1 mm (65Mn), slides into BAND-TOP from the +Y end | VERIFY M6 |
| Headband cushion foam | 1 | ≈24 × 100 × 8 mm, glued to the BAND-TOP inner ribs | buy |
| Mic gasket | 2 | PORON ring OD 4.0 / ID 1.4 / 1.8 thick | buy / die-cut |
| Acoustic mesh | 2 | Ø4 disc, glued into the 0.3 mm recess at each mic port | buy |
| Cell foam pad | 1 | 2 mm soft foam on the right-shell inner face over the cell | buy |
| Harness | 1 | 5-core 28-30 AWG silicone (HPR+, HPR-, BAT+, BAT-, NTC), ≈ 650 mm | buy |
| Thumbwheel encoder | 1 | SIQ-02FVS3 edge-drive dial encoder, Ø14.5 dial built in, 15 detents, push switch | from routing chat rev A.5 |
| Driver | 2 | 40 mm, 32 Ω (M5) | TBD — dimensions assumed |
| Ear pad | 2 | oval, opening ≥ 65 × 45 (M7) | TBD — PADRING adapts it |
| Li-Po 603450 | 1 | 1S ≈1000 mAh, PCM + 10 k NTC | TBD — measure |
| Boom mic | 1 | 3.5 mm, overmold ≤ Ø8.0 | TBD — measure |
