Orlandogani/pers-esp32-headset/mech/docs/orga_v1_component_envelope.csv

ref_orga_v1 | ref_headset_orga | value | footprint | x_mm | y_mm | box_cx | box_cy | rot_deg | side | body_L | body_W | body_H | z_top_mm | mech_interface | dnp | dim_source
D2 | D3 | RED (charging) | LED_0603_1608Metric | -24.05 | -14.35 | -24.05 | -14.35 | 90.0 | top | 1.6 | 0.8 | 0.8 | 2.4 | Charge LED (light pipe, share with D6) | False | chip LED
D6 | D7 | 150141M173100 RGB (CA) | LED_RGB_Wuerth-PLCC4_3.2x2.8mm_150141M173100 | -26.2 | 9.0 | -26.2 | 9.0 | 90.0 | top | 3.2 | 2.8 | 1.9 | 3.5 | RGB status LED (light pipe) | False | Würth 150141M173100 PLCC4, H ≈1.9 — VERIFY
H1 | (add) | M2 | MountingHole_2.2mm_M2 | -21.5 | 15.5 | -21.5 | 15.5 | 0.0 | top |  |  | 0 | 1.6 | M2 mounting hole | False | M2 hole Ø2.2
H2 | (add) | M2 | MountingHole_2.2mm_M2 | 14.0 | -3.0 | 14.0 | -3.0 | 0.0 | top |  |  | 0 | 1.6 | M2 mounting hole | False | M2 hole Ø2.2
J1 | J1 | USB-C (GCT USB4105-GF-A) | USB_C_Receptacle_GCT_USB4105-xx-A_16P_TopMnt_Horizontal | 0.0 | -27.9 | 0.0 | -27.9 | 0.0 | top | 8.94 | 7.35 | 3.31 | 4.91 | USB-C port (shell opening, plug overmold clearance) | False | GCT USB4105 drawing (8.94 × 7.35, H 3.31) — verify
J2 | J3 | BATTERY SM03B-SRSS-TB | JST_SH_SM03B-SRSS-TB_1x03-1MP_P1.00mm_Horizontal | -25.0 | -8.5 | -25.0 | -8.5 | -90.0 | top | 6.06 | 6.3 | 2.95 | 4.55 | Battery cable (JST SH 3p) | False | JST SH horizontal, H 2.95 + mated plug — VERIFY
J3 | J4 | BOOM MIC 3.5mm (SJ2-3593D-SMT) | Jack_3.5mm_CUI_SJ2-3593D-SMT_Horizontal | 19.733 | -12.0 | 18.43 | -12.0 | -90.0 | top | 20.1 | 10.7 | 5.0 | 6.6 | Boom-mic 3.5 mm jack (shell opening) | False | courtyard; H ≈5.0 — VERIFY against SJ2-3593D-SMT drawing
J4 | J5 | SPK LEFT SM02B-SRSS-G-TB | JST_SH_SM02B-SRSS-TB_1x02-1MP_P1.00mm_Horizontal | -17.5 | -8.5 | -17.5 | -8.5 | 0.0 | top | 5.3 | 6.06 | 2.95 | 4.55 | Left driver cable (JST SH 2p) | False | JST SH horizontal, H 2.95 + mated plug — VERIFY
J5 | J6 | SPK RIGHT SM02B-SRSS-G-TB | JST_SH_SM02B-SRSS-TB_1x02-1MP_P1.00mm_Horizontal | 10.3 | -23.0 | 10.3 | -23.0 | -25.0 | top | 7.53 | 7.9 | 2.95 | 4.55 | Right-cup harness (JST SH 2p) | False | JST SH horizontal, H 2.95 + mated plug — VERIFY
MK1 | MK1 | IM73D122V01 (voice, L) | Infineon_PG-LLGA-5-3_IM73D122 | -16.0 | -22.0 | -16.0 | -22.0 | 0.0 | top | 4.0 | 3.0 | 1.2 | 2.8 | Voice mic port (shell hole + gasket + mesh) | False | Infineon IM73D122V01 (4 × 3 × 1.2), bottom port Ø0.8 PCB hole
MK2 | MK2 | IM73D122V01 (reference, R) | Infineon_PG-LLGA-5-3_IM73D122 | 15.5 | 16.5 | 15.5 | 16.5 | 0.0 | top | 4.0 | 3.0 | 1.2 | 2.8 | Reference mic port (shell hole + gasket + mesh) | False | Infineon IM73D122V01 (4 × 3 × 1.2), bottom port Ø0.8 PCB hole
MK3 | MK3 | IM73D122V01 (inner cup) | Infineon_PG-LLGA-5-3_IM73D122 | -1.25 | -4.1 | -1.25 | -4.1 | 0.0 | bottom | 4.0 | 3.0 | 1.2 | -1.2 | Inner-cup mic (DNP) port | True | Infineon IM73D122V01 (4 × 3 × 1.2), bottom port Ø0.8 PCB hole
SW1 | SW1 | POWER (side) | SW_SPST_EVQP7A | -28.8 | -0.0 | -28.8 | -0.0 | 90.0 | top | 3.5 | 2.9 | 1.35 | 2.95 | POWER side-push (shell key) | False | Panasonic EVQ-P7 side-push — VERIFY
SW2 | SW2 | BOOT | SW_SPST_B3U-1000P | -12.85 | 10.7 | -12.85 | 10.7 | 0.0 | top | 3.0 | 2.5 | 1.6 | 3.2 | BOOT (internal access only) | False | Omron B3U-1000P top-push — VERIFY
SW3 | SW3 | PEC09-2125K-N0012 (placeholder) | RotaryEncoder_Bourns_Horizontal_PEC09-2xxxF-Nxxxx | 21.817 | 8.0 | 23.07 | 10.5 | 0.0 | top | 7.0 | 9.5 | 7.5 | 9.1 | Thumbwheel encoder (PLACEHOLDER, shell slot) | False | PLACEHOLDER part (PEC09); real thumbwheel TBD
SW4 | SW4 | MFB (side) | SW_SPST_EVQP7A | 28.684 | -1.0 | 28.68 | -1.0 | -90.0 | top | 3.5 | 2.9 | 1.35 | 2.95 | MFB side-push (shell key) | False | Panasonic EVQ-P7 side-push — VERIFY
U6 | U2 | ESP32-S3-WROOM-1-N16R8 | ESP32-S3-WROOM-1 | 0.0 | 13.2 | 0.0 | 13.25 | 0.0 | top | 18.0 | 25.5 | 3.1 | 4.7 | ESP32-S3 module — antenna end at flat edge, no metal ≥15 mm | False | Espressif datasheet §10.1 (18 × 25.5 × 3.1)
U8 | U9 | LSM6DSV16X | LGA-14_3x2.5mm_P0.5mm_LayoutBorder3x4y | 13.0 | 11.2 | 13.0 | 11.2 | 0.0 | top | 3.0 | 2.5 | 0.86 | 2.46 | IMU — record axis orientation in assembly | False | ST LSM6DSV16X LGA-14
C1 |  | 4.7nF | C_0402_1005Metric | -6.55 | -26.45 | -6.55 | -26.45 | 0.0 | top | 1.0 | 0.5 | 0.55 | 2.15 |  | False | chip
C10 |  | 10uF | C_0603_1608Metric | -6.3 | -7.0 | -6.3 | -7.0 | 0.0 | top | 1.6 | 0.8 | 0.9 | 2.5 |  | False | chip
C11 |  | 1uF | C_0402_1005Metric | 2.15 | -19.5 | 2.15 | -19.5 | 0.0 | top | 1.0 | 0.5 | 0.55 | 2.15 |  | False | chip
C12 |  | 1uF | C_0402_1005Metric | 1.85 | -14.5 | 1.85 | -14.5 | 0.0 | top | 1.0 | 0.5 | 0.55 | 2.15 |  | False | chip
C13 |  | 1uF | C_0402_1005Metric | 5.45 | -3.5 | 5.45 | -3.5 | 0.0 | top | 1.0 | 0.5 | 0.55 | 2.15 |  | False | chip
C14 |  | 1uF | C_0402_1005Metric | 2.1 | -3.7 | 2.1 | -3.7 | 0.0 | top | 1.0 | 0.5 | 0.55 | 2.15 |  | False | chip
C15 |  | 22uF | C_0805_2012Metric | -13.0 | 16.2 | -13.0 | 16.2 | 0.0 | top | 2.0 | 1.25 | 1.35 | 2.95 |  | False | chip
C16 |  | 10uF | C_0603_1608Metric | -12.0 | 14.15 | -12.0 | 14.15 | 0.0 | top | 1.6 | 0.8 | 0.9 | 2.5 |  | False | chip
C17 |  | 100nF | C_0402_1005Metric | -13.05 | 17.95 | -13.05 | 17.95 | 0.0 | top | 1.0 | 0.5 | 0.55 | 2.15 |  | False | chip
C18 |  | 1uF | C_0402_1005Metric | -14.4 | 13.8 | -14.4 | 13.8 | 90.0 | top | 1.0 | 0.5 | 0.55 | 2.15 |  | False | chip
C19 |  | 10nF | C_0402_1005Metric | 10.25 | -5.5 | 10.25 | -5.5 | 0.0 | top | 1.0 | 0.5 | 0.55 | 2.15 |  | True | chip
C2 |  | 10uF | C_0805_2012Metric | -10.35 | -24.1 | -10.35 | -24.1 | 90.0 | top | 2.0 | 1.25 | 1.35 | 2.95 |  | False | chip
C20 |  | 100nF | C_0402_1005Metric | 6.0 | -14.5 | 6.0 | -14.5 | 0.0 | top | 1.0 | 0.5 | 0.55 | 2.15 |  | False | chip
C21 |  | 100nF | C_0402_1005Metric | 6.2 | -15.75 | 6.2 | -15.75 | 0.0 | top | 1.0 | 0.5 | 0.55 | 2.15 |  | False | chip
C22 |  | 10uF | C_0603_1608Metric | 6.3 | -17.25 | 6.3 | -17.25 | 0.0 | top | 1.6 | 0.8 | 0.9 | 2.5 |  | False | chip
C23 |  | 100nF | C_0402_1005Metric | 5.45 | -19.2 | 5.45 | -19.2 | 90.0 | top | 1.0 | 0.5 | 0.55 | 2.15 |  | False | chip
C24 |  | 10uF | C_0603_1608Metric | 4.25 | -21.3 | 4.25 | -21.3 | 0.0 | top | 1.6 | 0.8 | 0.9 | 2.5 |  | False | chip
C25 |  | 100nF | C_0402_1005Metric | 4.25 | -6.7 | 4.25 | -6.7 | 0.0 | top | 1.0 | 0.5 | 0.55 | 2.15 |  | False | chip
C26 |  | 100nF | C_0402_1005Metric | 6.5 | -6.5 | 6.5 | -6.5 | 0.0 | top | 1.0 | 0.5 | 0.55 | 2.15 |  | False | chip
C27 |  | 10uF | C_0603_1608Metric | 5.35 | -5.0 | 5.35 | -5.0 | 0.0 | top | 1.6 | 0.8 | 0.9 | 2.5 |  | False | chip
C28 |  | 1uF | C_0402_1005Metric | 2.85 | -2.4 | 2.85 | -2.4 | 0.0 | top | 1.0 | 0.5 | 0.55 | 2.15 |  | False | chip
C29 |  | 1nF | C_0402_1005Metric | 15.4 | -22.25 | 15.4 | -22.25 | 90.0 | top | 1.0 | 0.5 | 0.55 | 2.15 |  | False | chip
C3 |  | 1uF | C_0603_1608Metric | -21.0 | -13.8 | -21.0 | -13.8 | 90.0 | top | 1.6 | 0.8 | 0.9 | 2.5 |  | False | chip
C30 |  | 1uF | C_0402_1005Metric | 2.85 | -1.15 | 2.85 | -1.15 | 0.0 | top | 1.0 | 0.5 | 0.55 | 2.15 |  | True | chip
C31 |  | 1uF | C_0402_1005Metric | -14.1 | -18.8 | -14.1 | -18.8 | 0.0 | top | 1.0 | 0.5 | 0.55 | 2.15 |  | False | chip
C32 |  | 1uF | C_0402_1005Metric | 12.5 | 14.5 | 12.5 | 14.5 | 0.0 | top | 1.0 | 0.5 | 0.55 | 2.15 |  | False | chip
C33 |  | 1uF | C_0402_1005Metric | 2.05 | -14.5 | 2.05 | -14.5 | 0.0 | bottom | 1.0 | 0.5 | 0.55 | -0.55 |  | True | chip
C34 |  | 100nF | C_0402_1005Metric | 13.85 | 8.85 | 13.85 | 8.85 | 0.0 | top | 1.0 | 0.5 | 0.55 | 2.15 |  | False | chip
C35 |  | 100nF | C_0402_1005Metric | 15.75 | 11.2 | 15.75 | 11.2 | 90.0 | top | 1.0 | 0.5 | 0.55 | 2.15 |  | False | chip
C36 |  | 10nF | C_0402_1005Metric | 16.05 | 12.9 | 16.05 | 12.9 | 0.0 | top | 1.0 | 0.5 | 0.55 | 2.15 |  | False | chip
C37 |  | 10nF | C_0402_1005Metric | 14.1 | 7.6 | 14.1 | 7.6 | 0.0 | top | 1.0 | 0.5 | 0.55 | 2.15 |  | False | chip
C38 |  | 100nF | C_0402_1005Metric | 17.0 | 11.2 | 17.0 | 11.2 | 90.0 | top | 1.0 | 0.5 | 0.55 | 2.15 |  | False | chip
C4 |  | 4.7uF | C_0603_1608Metric | -14.4 | -13.7 | -14.4 | -13.7 | 90.0 | top | 1.6 | 0.8 | 0.9 | 2.5 |  | False | chip
C5 |  | 4.7uF | C_0603_1608Metric | -13.55 | -10.3 | -13.55 | -10.3 | 90.0 | top | 1.6 | 0.8 | 0.9 | 2.5 |  | False | chip
C6 |  | 100nF | C_0402_1005Metric | -11.6 | -13.0 | -11.6 | -13.0 | 90.0 | top | 1.0 | 0.5 | 0.55 | 2.15 |  | False | chip
C7 |  | 100nF | C_0402_1005Metric | -3.6 | -7.15 | -3.6 | -7.15 | 0.0 | top | 1.0 | 0.5 | 0.55 | 2.15 |  | False | chip
C8 |  | 10uF | C_0603_1608Metric | -5.8 | -13.0 | -5.8 | -13.0 | 0.0 | top | 1.6 | 0.8 | 0.9 | 2.5 |  | False | chip
C9 |  | 10uF | C_0603_1608Metric | -9.0 | -10.4 | -9.0 | -10.4 | 90.0 | top | 1.6 | 0.8 | 0.9 | 2.5 |  | False | chip
D1 | D1 | SMF5V0A-E3-08 | D_SMF | -6.65 | -18.8 | -6.65 | -18.8 | 0.0 | top | 2.8 | 1.9 | 1.1 | 2.7 |  | False | SMF
D3 | D4 | BAT54CLT3G | SOT-23 | -24.25 | -2.0 | -24.25 | -2.0 | 90.0 | top | 2.9 | 2.4 | 1.45 | 3.05 |  | False | SOT-23 max
D4 | D6 | TPD1E10B06 | D_0402_1005Metric | 6.7 | -28.0 | 6.7 | -28.0 | 0.0 | top | 1.0 | 0.5 | 0.6 | 2.2 |  | False | chip
D5 | D5 | TPD1E10B06 | D_0402_1005Metric | 9.7 | -28.0 | 9.7 | -28.0 | 0.0 | top | 1.0 | 0.5 | 0.6 | 2.2 |  | False | chip
FB1 |  | BLM18PG221SN1D | L_0603_1608Metric | 15.55 | -19.5 | 15.55 | -19.5 | 90.0 | top | 1.6 | 0.8 | 0.9 | 2.5 |  | False | chip
FB2 |  | BLM18PG221SN1D | L_0603_1608Metric | -17.0 | 14.7 | -17.0 | 14.7 | 90.0 | top | 1.6 | 0.8 | 0.9 | 2.5 |  | False | chip
L1 | L1 | 2.2uH Wurth 74438335022 | L_Wuerth_MAPI-3015 | -1.75 | -10.0 | -1.75 | -10.0 | 0.0 | top | 3.0 | 3.0 | 1.5 | 3.1 |  | False | Würth 74438335022 (3.0 × 3.0 × 1.5)
Q1 | Q1 | SI2302CDS-T1-GE3 | SOT-23 | -21.9 | 1.95 | -21.9 | 1.95 | 0.0 | top | 2.9 | 2.4 | 1.45 | 3.05 |  | False | SOT-23 max
R1 |  | 5.1k | R_0402_1005Metric | -4.7 | -21.85 | -4.7 | -21.85 | 90.0 | top | 1.0 | 0.5 | 0.4 | 2.0 |  | False | chip
R10 |  | 0R | R_0805_2012Metric | -11.55 | -10.0 | -11.55 | -10.0 | 90.0 | top | 2.0 | 1.25 | 0.6 | 2.2 |  | False | chip
R11 |  | 1M | R_0402_1005Metric | -14.65 | -17.25 | -14.65 | -17.25 | 0.0 | top | 1.0 | 0.5 | 0.4 | 2.0 |  | False | chip
R12 |  | 1M | R_0402_1005Metric | -13.65 | -7.5 | -13.65 | -7.5 | 90.0 | top | 1.0 | 0.5 | 0.4 | 2.0 |  | False | chip
R13 |  | 1M | R_0402_1005Metric | -27.3 | -3.55 | -27.3 | -3.55 | 0.0 | top | 1.0 | 0.5 | 0.4 | 2.0 |  | False | chip
R14 |  | 100k | R_0402_1005Metric | -25.2 | 0.75 | -25.2 | 0.75 | 0.0 | top | 1.0 | 0.5 | 0.4 | 2.0 |  | False | chip
R15 |  | 1k | R_0402_1005Metric | -21.75 | -2.0 | -21.75 | -2.0 | 90.0 | top | 1.0 | 0.5 | 0.4 | 2.0 |  | False | chip
R16 |  | 10k | R_0402_1005Metric | -21.1 | -3.7 | -21.1 | -3.7 | 0.0 | top | 1.0 | 0.5 | 0.4 | 2.0 |  | False | chip
R17 |  | 0R | R_0402_1005Metric | -9.25 | -8.1 | -9.25 | -8.1 | 0.0 | top | 1.0 | 0.5 | 0.4 | 2.0 |  | False | chip
R18 |  | 0R | R_0402_1005Metric | -8.15 | -13.4 | -8.15 | -13.4 | 90.0 | top | 1.0 | 0.5 | 0.4 | 2.0 |  | False | chip
R19 |  | 0R | R_0402_1005Metric | -2.95 | -12.95 | -2.95 | -12.95 | 0.0 | top | 1.0 | 0.5 | 0.4 | 2.0 |  | True | chip
R2 |  | 5.1k | R_0402_1005Metric | -7.1 | -20.75 | -7.1 | -20.75 | 0.0 | top | 1.0 | 0.5 | 0.4 | 2.0 |  | False | chip
R20 |  | 10k | R_0402_1005Metric | -15.5 | 15.95 | -15.5 | 15.95 | 90.0 | top | 1.0 | 0.5 | 0.4 | 2.0 |  | False | chip
R21 |  | 10k | R_0402_1005Metric | -15.45 | 17.95 | -15.45 | 17.95 | 0.0 | top | 1.0 | 0.5 | 0.4 | 2.0 |  | False | chip
R22 |  | 22R | R_0402_1005Metric | -12.0 | 6.2 | -12.0 | 6.2 | 0.0 | top | 1.0 | 0.5 | 0.4 | 2.0 |  | False | chip
R23 |  | 22R | R_0402_1005Metric | -11.8 | 4.95 | -11.8 | 4.95 | 0.0 | top | 1.0 | 0.5 | 0.4 | 2.0 |  | False | chip
R24 |  | 22R | R_0402_1005Metric | -12.05 | 7.45 | -12.05 | 7.45 | 0.0 | top | 1.0 | 0.5 | 0.4 | 2.0 |  | False | chip
R25 |  | 22R | R_0402_1005Metric | -13.75 | 6.05 | -13.75 | 6.05 | 90.0 | top | 1.0 | 0.5 | 0.4 | 2.0 |  | False | chip
R26 |  | 22R | R_0402_1005Metric | -11.85 | 3.7 | -11.85 | 3.7 | 0.0 | top | 1.0 | 0.5 | 0.4 | 2.0 |  | False | chip
R27 |  | 4.7k | R_0402_1005Metric | -14.3 | 7.75 | -14.3 | 7.75 | 0.0 | top | 1.0 | 0.5 | 0.4 | 2.0 |  | False | chip
R28 |  | 4.7k | R_0402_1005Metric | -13.7 | 3.75 | -13.7 | 3.75 | 90.0 | top | 1.0 | 0.5 | 0.4 | 2.0 |  | False | chip
R29 |  | 100k | R_0402_1005Metric | -15.0 | 5.8 | -15.0 | 5.8 | 90.0 | top | 1.0 | 0.5 | 0.4 | 2.0 |  | False | chip
R3 |  | 1M | R_0402_1005Metric | -3.35 | -21.55 | -3.35 | -21.55 | 90.0 | top | 1.0 | 0.5 | 0.4 | 2.0 |  | False | chip
R30 |  | 22R | R_0402_1005Metric | 1.95 | -21.5 | 1.95 | -21.5 | 90.0 | top | 1.0 | 0.5 | 0.4 | 2.0 |  | False | chip
R31 |  | 0R | R_0402_1005Metric | 2.05 | -6.2 | 2.05 | -6.2 | 0.0 | top | 1.0 | 0.5 | 0.4 | 2.0 |  | False | chip
R32 |  | 0R | R_0402_1005Metric | 8.1 | -5.25 | 8.1 | -5.25 | 0.0 | top | 1.0 | 0.5 | 0.4 | 2.0 |  | True | chip
R33 |  | 100k | R_0402_1005Metric | 2.4 | -4.95 | 2.4 | -4.95 | 0.0 | top | 1.0 | 0.5 | 0.4 | 2.0 |  | False | chip
R34 |  | 2.2k | R_0402_1005Metric | 5.45 | -2.25 | 5.45 | -2.25 | 0.0 | top | 1.0 | 0.5 | 0.4 | 2.0 |  | False | chip
R35 |  | 100k | R_0402_1005Metric | 15.7 | -24.1 | 15.7 | -24.1 | 0.0 | top | 1.0 | 0.5 | 0.4 | 2.0 |  | False | chip
R36 |  | 10k | R_0402_1005Metric | 11.6 | 8.8 | 11.6 | 8.8 | 0.0 | top | 1.0 | 0.5 | 0.4 | 2.0 |  | False | chip
R37 |  | 10k | R_0402_1005Metric | 16.05 | 9.5 | 16.05 | 9.5 | 0.0 | top | 1.0 | 0.5 | 0.4 | 2.0 |  | False | chip
R38 |  | 10k | R_0402_1005Metric | 10.8 | 14.2 | 10.8 | 14.2 | 90.0 | top | 1.0 | 0.5 | 0.4 | 2.0 |  | False | chip
R39 |  | 470R | R_0402_1005Metric | -21.85 | 12.25 | -21.85 | 12.25 | 0.0 | top | 1.0 | 0.5 | 0.4 | 2.0 |  | False | chip
R4 |  | 1.8k | R_0402_1005Metric | -22.55 | -13.35 | -22.55 | -13.35 | 90.0 | top | 1.0 | 0.5 | 0.4 | 2.0 |  | False | chip
R40 |  | 68R | R_0402_1005Metric | -21.85 | 11.0 | -21.85 | 11.0 | 0.0 | top | 1.0 | 0.5 | 0.4 | 2.0 |  | False | chip
R41 |  | 68R | R_0402_1005Metric | -23.6 | 11.8 | -23.6 | 11.8 | 90.0 | top | 1.0 | 0.5 | 0.4 | 2.0 |  | False | chip
R5 |  | 1.5k | R_0402_1005Metric | -12.9 | -13.25 | -12.9 | -13.25 | 90.0 | top | 1.0 | 0.5 | 0.4 | 2.0 |  | False | chip
R6 |  | 10k | R_0402_1005Metric | -17.05 | -17.15 | -17.05 | -17.15 | 0.0 | top | 1.0 | 0.5 | 0.4 | 2.0 |  | False | chip
R7 |  | 10k | R_0402_1005Metric | -21.3 | -16.05 | -21.3 | -16.05 | 0.0 | top | 1.0 | 0.5 | 0.4 | 2.0 |  | True | chip
R8 |  | 10k | R_0402_1005Metric | -14.25 | -16.0 | -14.25 | -16.0 | 0.0 | top | 1.0 | 0.5 | 0.4 | 2.0 |  | False | chip
R9 |  | 1k | R_0402_1005Metric | -19.35 | -17.35 | -19.35 | -17.35 | 0.0 | top | 1.0 | 0.5 | 0.4 | 2.0 |  | False | chip
TP1 |  | VBUS | TestPoint_Pad_D1.0mm | -18.0 | -18.0 | -18.0 | -18.0 | 0.0 | bottom | 1.0 | 1.0 | 0.05 | -0.05 |  | False | pad only (pogo-pin target)
TP10 |  | ESP_EN | TestPoint_Pad_D1.0mm | -9.45 | -1.7 | -9.45 | -1.7 | 0.0 | bottom | 1.0 | 1.0 | 0.05 | -0.05 |  | False | pad only (pogo-pin target)
TP11 |  | ESP_IO0 | TestPoint_Pad_D1.0mm | 2.4 | -1.55 | 2.4 | -1.55 | 0.0 | bottom | 1.0 | 1.0 | 0.05 | -0.05 |  | False | pad only (pogo-pin target)
TP12 |  | +3V3 | TestPoint_Pad_D1.0mm | -11.85 | -1.6 | -11.85 | -1.6 | 0.0 | bottom | 1.0 | 1.0 | 0.05 | -0.05 |  | False | pad only (pogo-pin target)
TP13 |  | GND | TestPoint_Pad_D1.0mm | -4.55 | -4.05 | -4.55 | -4.05 | 0.0 | bottom | 1.0 | 1.0 | 0.05 | -0.05 |  | False | pad only (pogo-pin target)
TP14 |  | DBG_TIMING | TestPoint_Pad_D1.0mm | 4.75 | -1.6 | 4.75 | -1.6 | 0.0 | bottom | 1.0 | 1.0 | 0.05 | -0.05 |  | False | pad only (pogo-pin target)
TP15 |  | SPARE_IO48 | TestPoint_Pad_D1.0mm | -7.05 | -4.25 | -7.05 | -4.25 | 0.0 | bottom | 1.0 | 1.0 | 0.05 | -0.05 |  | False | pad only (pogo-pin target)
TP16 |  | USB_DP | TestPoint_Pad_D1.0mm | 1.85 | -3.95 | 1.85 | -3.95 | 0.0 | bottom | 1.0 | 1.0 | 0.05 | -0.05 |  | False | pad only (pogo-pin target)
TP17 |  | USB_DN | TestPoint_Pad_D1.0mm | -9.4 | -4.15 | -9.4 | -4.15 | 0.0 | bottom | 1.0 | 1.0 | 0.05 | -0.05 |  | False | pad only (pogo-pin target)
TP18 |  | HPL_P | TestPoint_Pad_D1.0mm | 14.7 | -18.9 | 14.7 | -18.9 | 0.0 | bottom | 1.0 | 1.0 | 0.05 | -0.05 |  | False | pad only (pogo-pin target)
TP19 |  | HPL_N | TestPoint_Pad_D1.0mm | 12.25 | -19.05 | 12.25 | -19.05 | 0.0 | bottom | 1.0 | 1.0 | 0.05 | -0.05 |  | False | pad only (pogo-pin target)
TP2 |  | +BATT | TestPoint_Pad_D1.0mm | -15.5 | -18.0 | -15.5 | -18.0 | 0.0 | bottom | 1.0 | 1.0 | 0.05 | -0.05 |  | False | pad only (pogo-pin target)
TP20 |  | HPR_P | TestPoint_Pad_D1.0mm | 17.05 | -18.95 | 17.05 | -18.95 | 0.0 | bottom | 1.0 | 1.0 | 0.05 | -0.05 |  | False | pad only (pogo-pin target)
TP21 |  | HPR_N | TestPoint_Pad_D1.0mm | 9.8 | -19.15 | 9.8 | -19.15 | 0.0 | bottom | 1.0 | 1.0 | 0.05 | -0.05 |  | False | pad only (pogo-pin target)
TP22 |  | MICBIAS | TestPoint_Pad_D1.0mm | 15.35 | -21.35 | 15.35 | -21.35 | 0.0 | bottom | 1.0 | 1.0 | 0.05 | -0.05 |  | False | pad only (pogo-pin target)
TP3 |  | VSYS | TestPoint_Pad_D1.0mm | -20.4 | -18.75 | -20.4 | -18.75 | 0.0 | bottom | 1.0 | 1.0 | 0.05 | -0.05 |  | False | pad only (pogo-pin target)
TP4 |  | +3V3 | TestPoint_Pad_D1.0mm | -19.15 | -21.05 | -19.15 | -21.05 | 0.0 | bottom | 1.0 | 1.0 | 0.05 | -0.05 |  | False | pad only (pogo-pin target)
TP5 |  | +1V8 | TestPoint_Pad_D1.0mm | -21.35 | -16.3 | -21.35 | -16.3 | 0.0 | bottom | 1.0 | 1.0 | 0.05 | -0.05 |  | False | pad only (pogo-pin target)
TP6 |  | +3V0 | TestPoint_Pad_D1.0mm | -14.3 | -15.4 | -14.3 | -15.4 | 0.0 | bottom | 1.0 | 1.0 | 0.05 | -0.05 |  | False | pad only (pogo-pin target)
TP7 |  | GND | TestPoint_Pad_D1.0mm | -13.0 | -18.0 | -13.0 | -18.0 | 0.0 | bottom | 1.0 | 1.0 | 0.05 | -0.05 |  | False | pad only (pogo-pin target)
TP8 |  | UART_TX | TestPoint_Pad_D1.0mm | -4.5 | -1.55 | -4.5 | -1.55 | 0.0 | bottom | 1.0 | 1.0 | 0.05 | -0.05 |  | False | pad only (pogo-pin target)
TP9 |  | UART_RX | TestPoint_Pad_D1.0mm | -6.9 | -1.75 | -6.9 | -1.75 | 0.0 | bottom | 1.0 | 1.0 | 0.05 | -0.05 |  | False | pad only (pogo-pin target)
U1 | U7 | USBLC6-2SC6 | SOT-23-6 | -7.35 | -23.6 | -7.35 | -23.6 | 90.0 | top | 2.9 | 2.8 | 1.45 | 3.05 |  | False | SOT-23-6 max
U2 | U1 | BQ24074RGTR | VQFN-16-1EP_3x3mm_P0.5mm_EP1.6x1.6mm_ThermalVias | -17.75 | -14.25 | -17.75 | -14.25 | 0.0 | top | 3.0 | 3.0 | 1.0 | 2.6 |  | False | TI RGT QFN-16
U3 | U3 | TPS63001DRCR | Texas_DRC0010J_ThermalVias | -6.0 | -10.0 | -6.0 | -10.0 | 0.0 | top | 3.0 | 3.0 | 1.0 | 2.6 |  | False | TI DRC SON-10
U4 | U4 | TLV75518PDBV | SOT-23-5 | 2.0 | -17.0 | 2.0 | -17.0 | 0.0 | top | 2.9 | 2.8 | 1.45 | 3.05 |  | False | SOT-23-5 max
U5 | U5 | LP5907MFX-3.0 | SOT-23-5 | 18.35 | -20.05 | 18.35 | -20.05 | 90.0 | top | 2.9 | 2.8 | 1.45 | 3.05 |  | False | SOT-23-5 max
U7 | U8 | TLV320AIC3104IRHBT | Texas_RHB0032E_VQFN-32-1EP_5x5mm_P0.5mm_EP3.45x3.45mm_ThermalVias | 4.4 | -10.6 | 4.4 | -10.6 | 0.0 | top | 5.0 | 5.0 | 1.0 | 2.6 |  | False | TI RHB QFN-32
Y1 | Y1 | 12.288MHz (DNP, ASE not stocked) | Oscillator_SMD_Abracon_ASE-4Pin_3.2x2.5mm | 9.15 | -2.7 | 9.15 | -2.7 | 0.0 | top | 3.2 | 2.5 | 1.2 | 2.8 |  | True | Abracon ASE (DNP)
