Orlandogani/pers-esp32-headset/mech/out/ORGA-PCB-outline-A.dxf

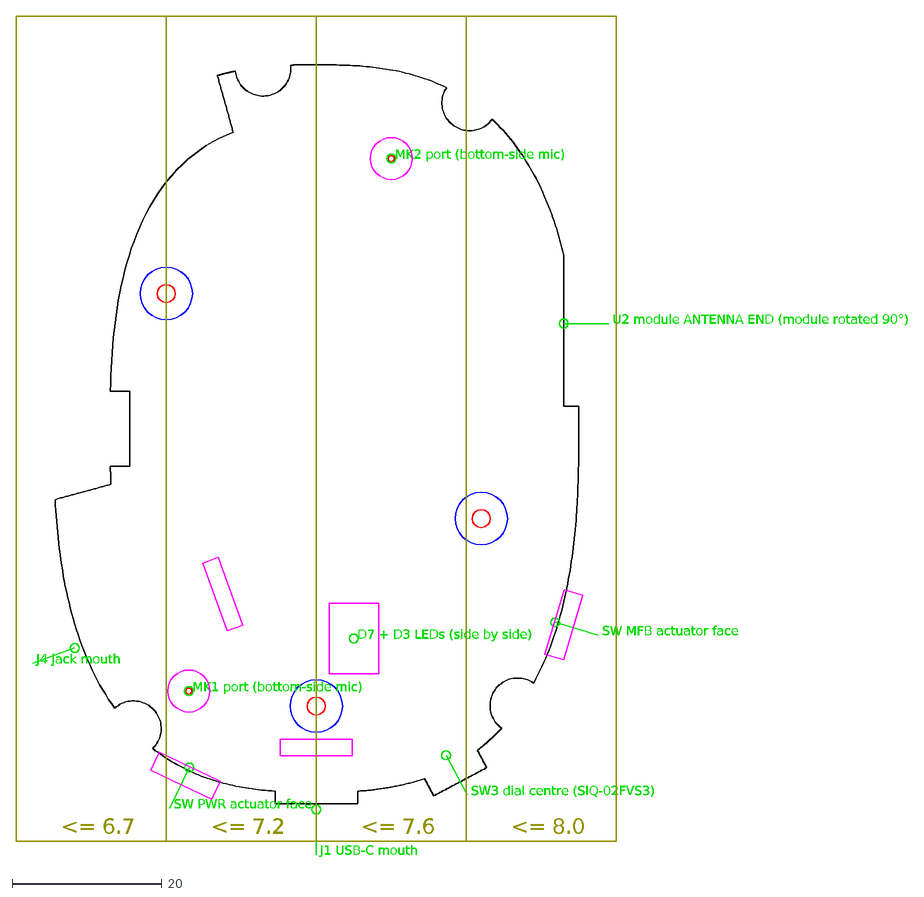
[picture p21: CAD file, 2026-10-14]
mech/out/ORGA-PCB-outline-A.dxf
J1 USB-C mouth
J4 jack mouth
SW MFB actuator face
SW PWR actuator face
SW3 dial centre (SIQ-02FVS3)
U2 module ANTENNA END (module rotated 90°)
D7 + D3 LEDs (side by side)
MK1 port (bottom-side mic)
MK2 port (bottom-side mic)
<= 6.7
<= 7.2
<= 7.6
<= 8.0
