Orlandogani/pers-esp32-headset/mech/renders/ORGA-guide-1_cup_exploded.png

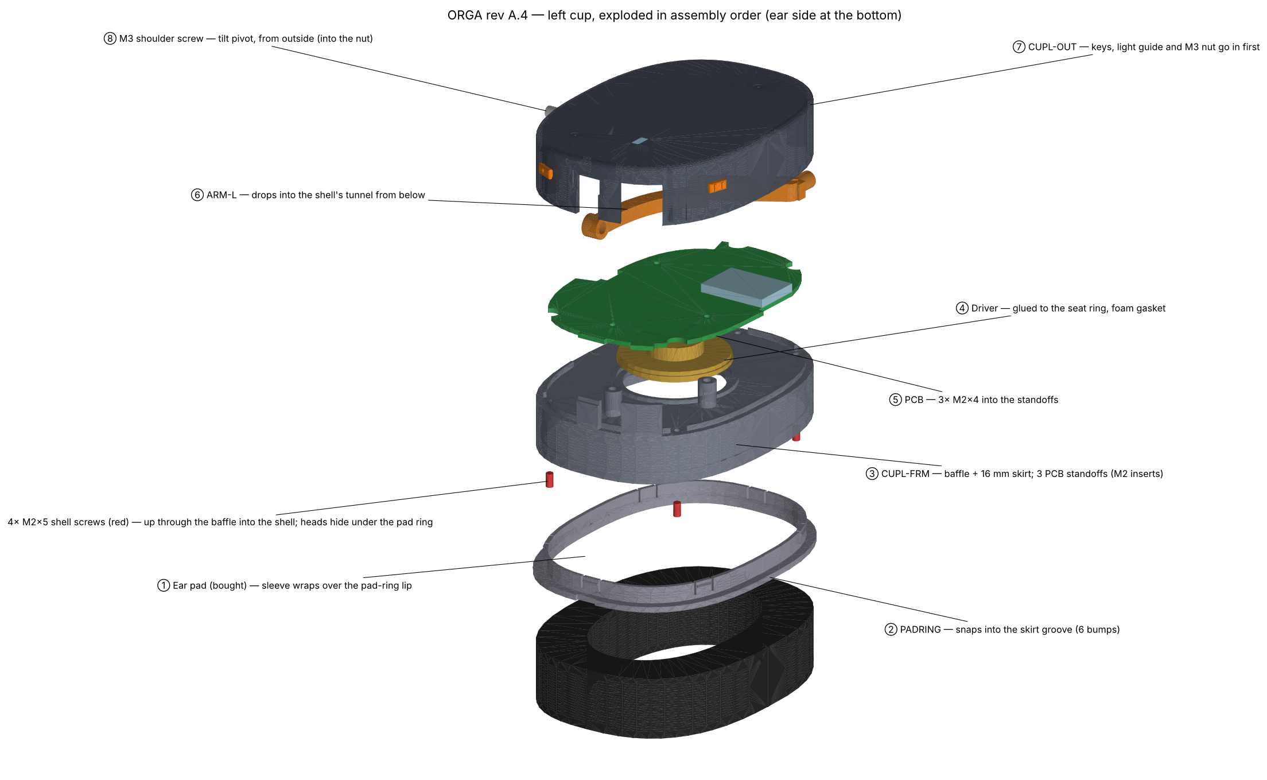
mech/renders/ORGA-guide-1_cup_exploded.png
