Orlandogani/pers-esp32-headset/mech/renders/ORGA-guide-2_pad_detail.png

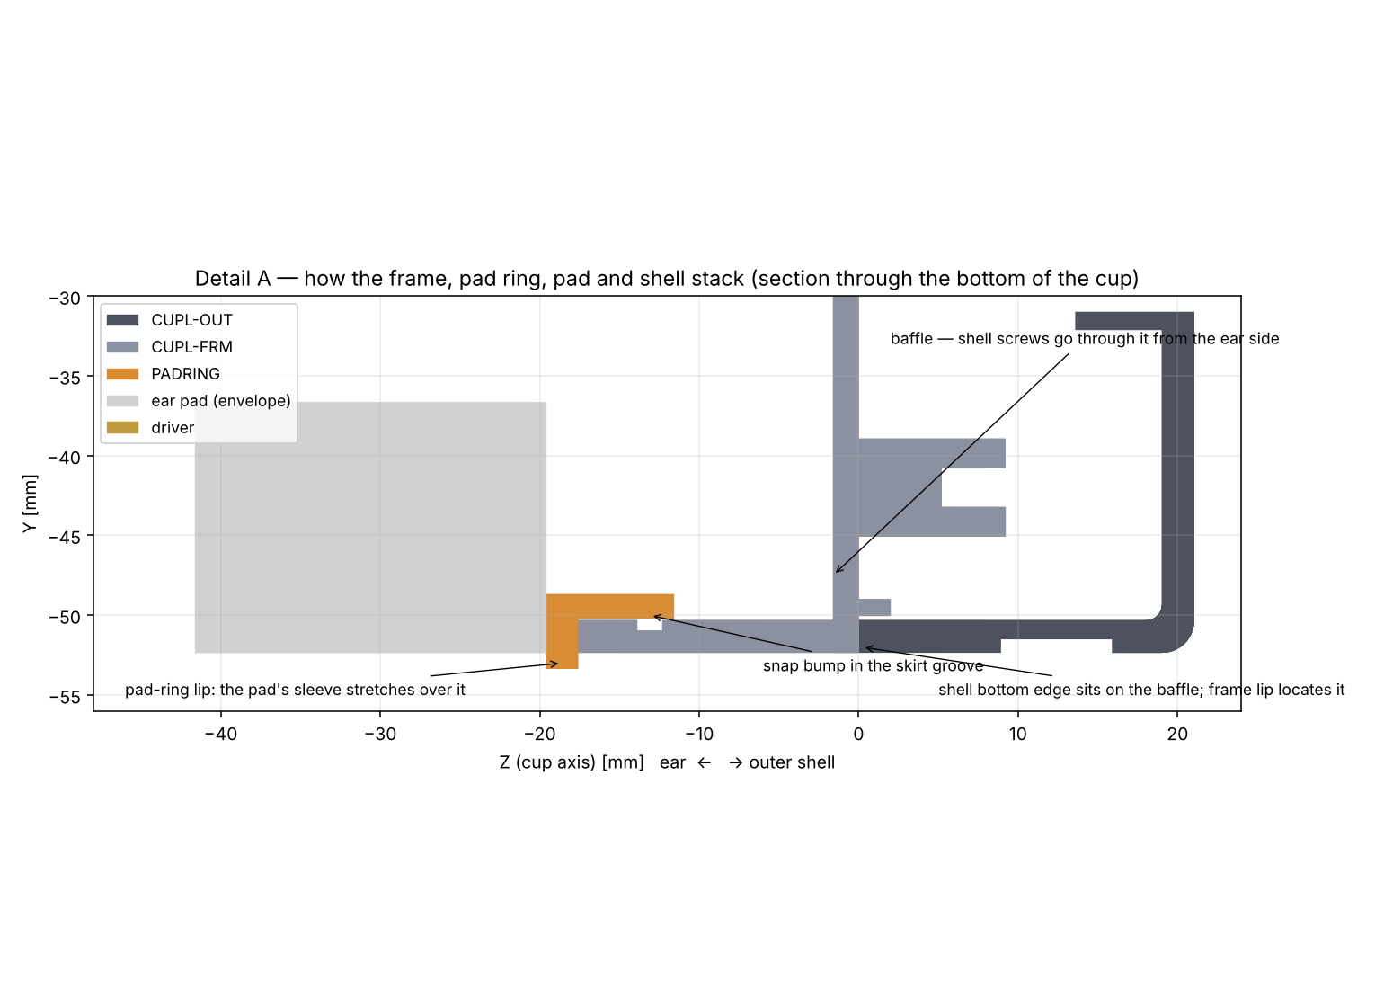
mech/renders/ORGA-guide-2_pad_detail.png
