Orlandogani/pers-esp32-headset/mech/renders/ORGA-guide-3_headband_exploded.png

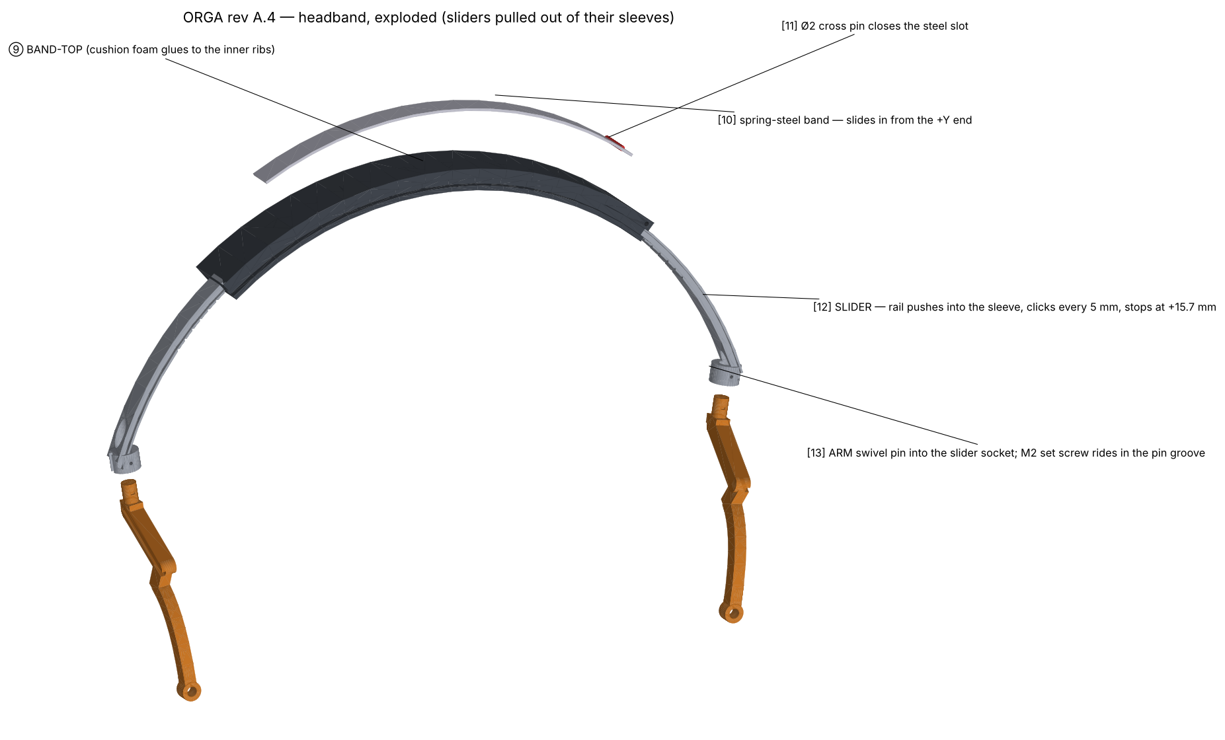
mech/renders/ORGA-guide-3_headband_exploded.png
