Orlandogani/pers-esp32-headset/mech/renders/ORGA-guide-4_slider_detail.png

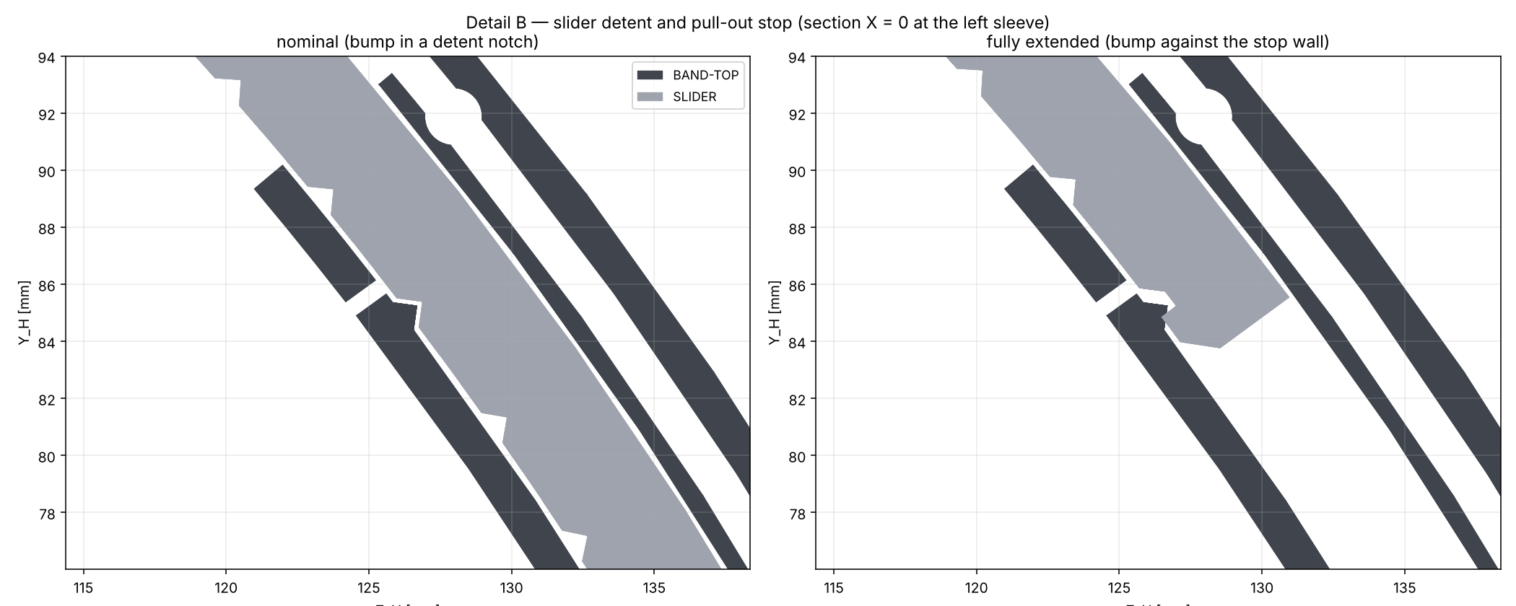
mech/renders/ORGA-guide-4_slider_detail.png
