Orlandogani/pers-esp32-headset/headset-orga.kicad_pcb

## KiCad design headset-orga.kicad_pcb (2026-10-14)

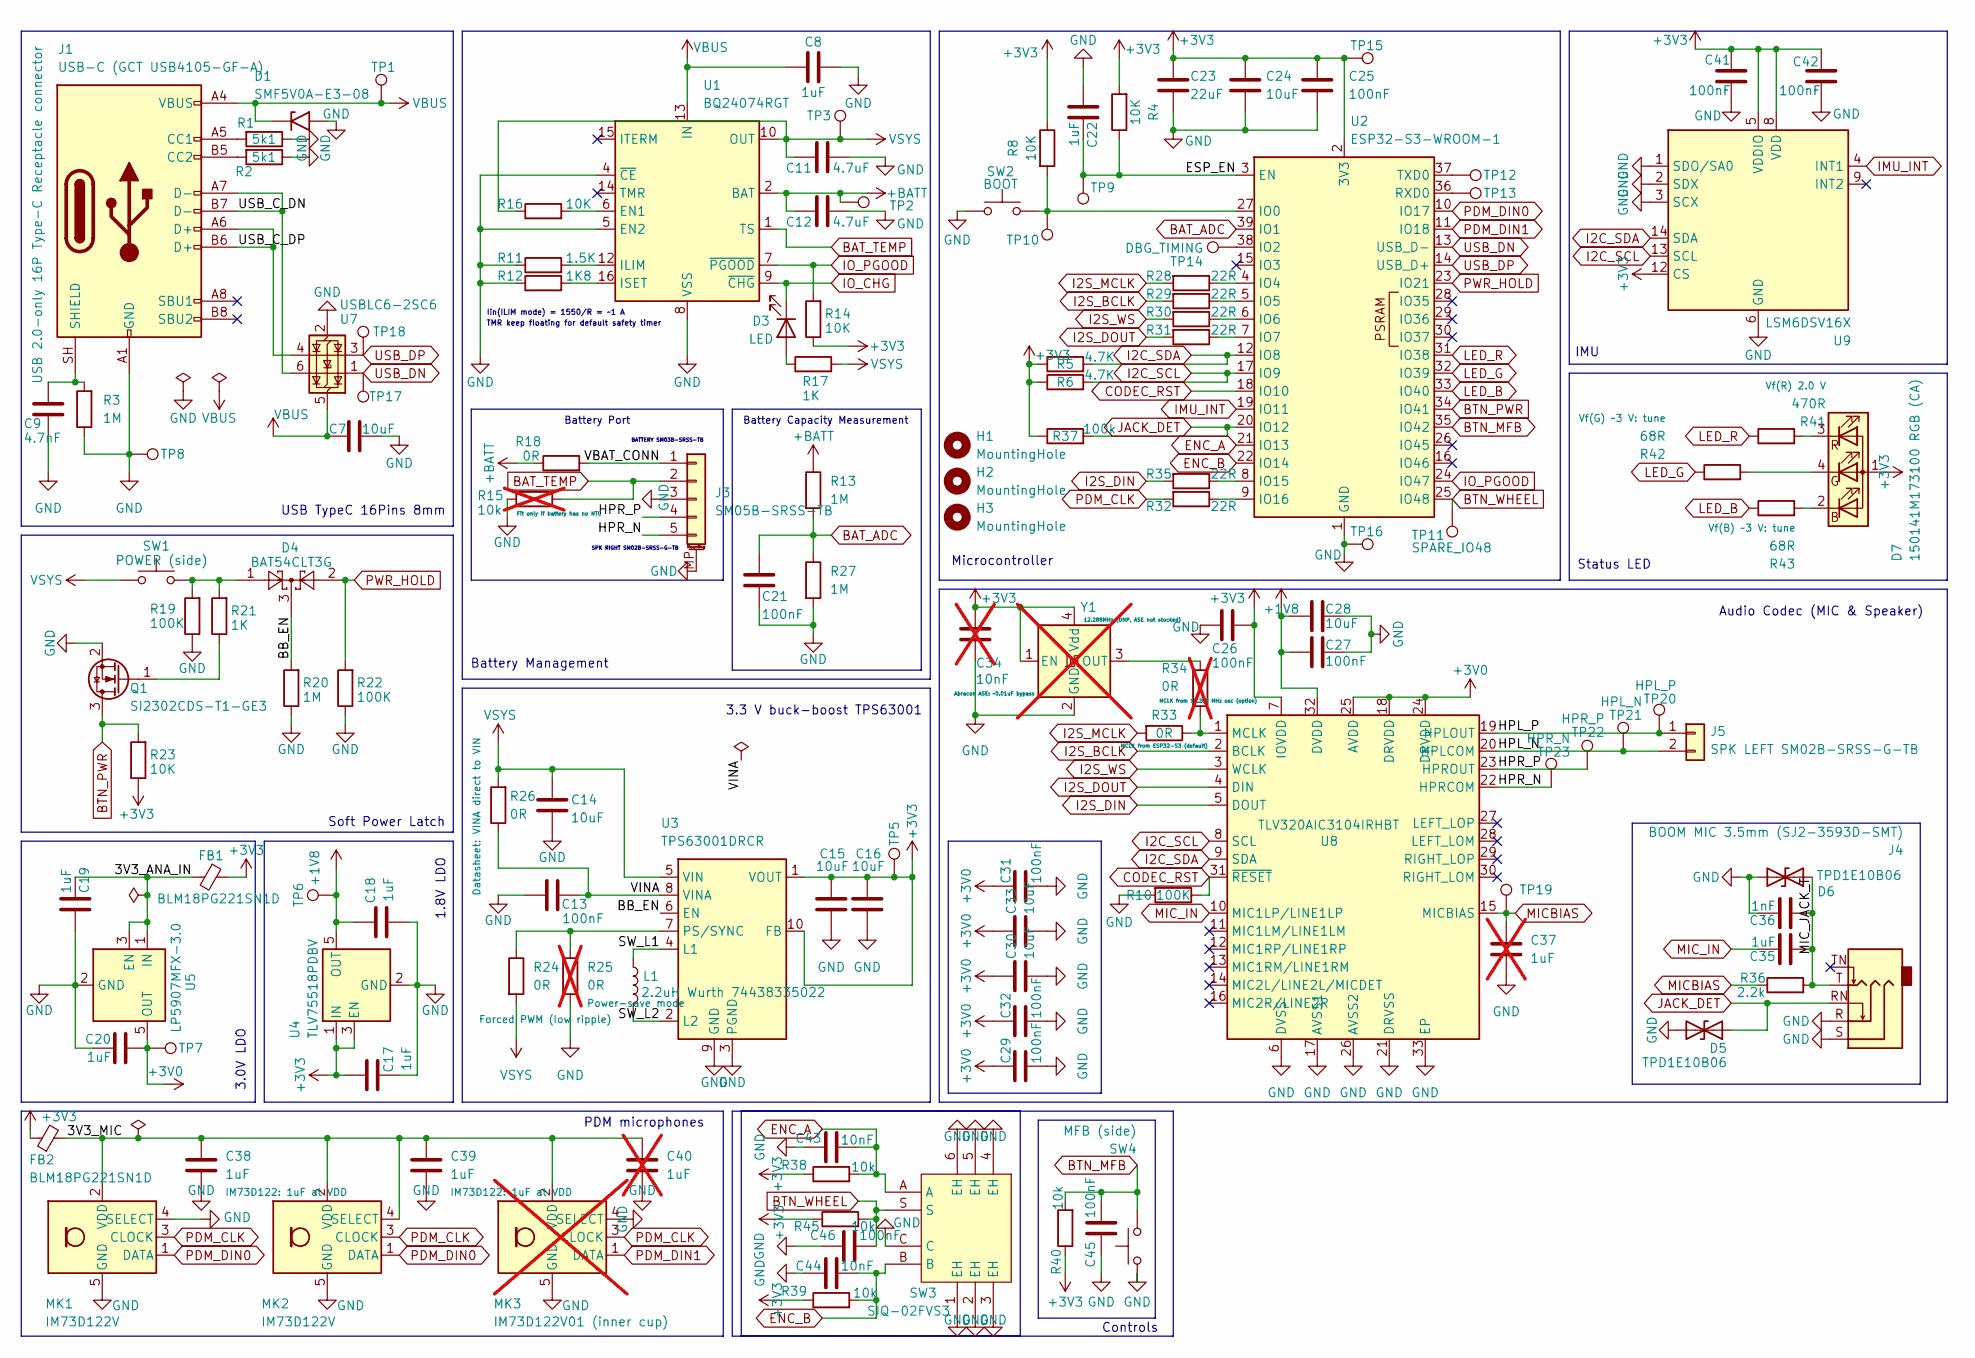
[picture p27: schematic headset-orga.kicad_sch, Headset - Omni Radiant Gaming Apparatus]

Parts:
C7: 10uF; C_0805_2012Metric
C8, C17, C18, C19, C20: 1uF; C_0603_1608Metric
C9: 4.7nF; C_0402_1005Metric
C11, C12: 4.7uF; C_0603_1608Metric
C13, C21, C25, C26, C27, C29, C31, C32, C41, C42, C45, C46: 100nF; C_0402_1005Metric
C14, C15, C16, C24: 10uF; C_0603_1608Metric
C22, C35, C38, C39: 1uF; C_0402_1005Metric
C23: 22uF; C_0805_2012Metric
C28, C30, C33: 10uF; C_0402_1005Metric
C34: 10nF; C_0402_1005Metric; not fitted
C36: 1nF; C_0402_1005Metric
C37, C40: 1uF; C_0402_1005Metric; not fitted
C43, C44: 10nF; C_0402_1005Metric
D1: SMF5V0A-E3-08; D_SMF
D3: LED; LED_0603_1608Metric
D4: BAT54CLT3G; SOT-23
D5, D6: TPD1E10B06; D_0402_1005Metric
D7: 150141M173100 RGB (CA); LED_RGB_Wuerth-PLCC4_3.2x2.8mm_150141M173100
FB1, FB2: BLM18PG221SN1D; L_0603_1608Metric
H1, H2, H3: MountingHole; MountingHole_2.4mm_M2
J1: USB-C (GCT USB4105-GF-A); USB_C_Receptacle_GCT_USB4105-xx-A_16P_TopMnt_Horizontal
J3: SM05B-SRSS-TB; JST_SH_SM05B-SRSS-TB_1x05-1MP_P1.00mm_Horizontal
J4: BOOM MIC 3.5mm (SJ2-3593D-SMT); Jack_3.5mm_CUI_SJ2-3593D-SMT_Horizontal
J5: SPK LEFT SM02B-SRSS-G-TB; JST_SH_SM02B-SRSS-TB_1x02-1MP_P1.00mm_Horizontal
L1: 2.2uH Wurth 74438335022; L_Wuerth_MAPI-3015
MK1, MK2: IM73D122V; Infineon_PG-LLGA-5-3_IM73D122
MK3: IM73D122V01 (inner cup); Infineon_PG-LLGA-5-3_IM73D122; not fitted
Q1: SI2302CDS-T1-GE3; SOT-23
R1, R2: 5k1; R_0603_1608Metric
R3, R20: 1M; R_0603_1608Metric
R4, R8, R14, R16, R23: 10K; R_0603_1608Metric
R5, R6: 4.7K; R_0603_1608Metric
R10, R19, R22: 100K; R_0603_1608Metric
R11: 1.5K; R_0603_1608Metric
R12: 1K8; R_0603_1608Metric
R13, R27: 1M; R_0402_1005Metric
R15: 10k; R_0402_1005Metric; not fitted
R17, R21: 1K; R_0603_1608Metric
R18, R33: 0R; R_0603_1608Metric
R24, R26: 0R; R_0402_1005Metric
R25, R34: 0R; R_0402_1005Metric; not fitted
R28, R29, R30, R31, R32, R35: 22R; R_0603_1608Metric
R36: 2.2k; R_0603_1608Metric
R37: 100k; R_0603_1608Metric
R38, R39, R40, R45: 10k; R_0402_1005Metric
R41: 470R; R_0402_1005Metric
R42, R43: 68R; R_0402_1005Metric
SW1: POWER (side); SW_SPST_EVQP7A
SW2: BOOT; SW_SPST_EVQP7A
SW3: SIQ-02FVS3; SW-SMD_SIQ-02FVS3_1; MPN SIQ-02FVS3; LCSC C2925423
SW4: MFB (side); SW_SPST_EVQP7A
TP1, TP2, TP3, TP5, TP6, TP7, TP8, TP9, TP10, TP15, TP16, TP17, TP18, TP19: TestPoint; TestPoint_Pad_D1.0mm
TP11: SPARE_IO48; TestPoint_Pad_D1.0mm
TP12: TX0; TestPoint_Pad_D1.0mm
TP13: RX0; TestPoint_Pad_D1.0mm
TP14: DBG_TIMING; TestPoint_Pad_D1.0mm
TP20: HPL_P; TestPoint_Pad_D1.0mm
TP21: HPL_N; TestPoint_Pad_D1.0mm
TP22: HPR_P; TestPoint_Pad_D1.0mm
TP23: HPR_N; TestPoint_Pad_D1.0mm
U1: BQ24074RGT; VQFN-16-1EP_3x3mm_P0.5mm_EP1.6x1.6mm_ThermalVias
U2: ESP32-S3-WROOM-1
U3: TPS63001DRCR; Texas_DRC0010J_ThermalVias
U4: TLV75518PDBV; SOT-23-5
U5: LP5907MFX-3.0; SOT-23-5
U7: USBLC6-2SC6; SOT-23-6
U8: TLV320AIC3104IRHBT; Texas_RHB0032E_VQFN-32-1EP_5x5mm_P0.5mm_EP3.45x3.45mm_Therm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
U9: LSM6DSV16X; LGA-14_3x2.5mm_P0.5mm_LayoutBorder3x4y
Y1: 12.288MHz (DNP, ASE not stocked); Oscillator_SMD_Abracon_ASE-4Pin_3.2x2.5mm; not fitted

Connections:
+1V8: C18.2, C27.1, C28.1, TP6.1 (1_1), U4.5 (OUT), U8.32 (DVDD)
+3V0: C20.2, C29.1, C30.1, C31.1, C32.1, C33.1, TP7.1 (1_1), U5.5 (OUT), U8.18 (DRVDD), U8.24 (DRVDD), U8.25 (AVDD)
+3V3: C15.2, C16.2, C17.2, C23.1, C24.1, C25.1, C26.2, C34.1, C41.1, C42.1, D7.1 (A), FB1.1, FB2.1, R4.2, R5.1, R6.1, R8.1, R14.1, R23.1, R37.1, R38.1, R39.1, R40.1, R45.1, TP5.1 (1_1), TP15.1 (1_1), U2.2 (3V3), U3.1 (VOUT), U3.10 (FB), U4.1 (IN), U4.3 (EN), U8.7 (IOVDD), U9.5 (VDDIO), U9.8 (VDD), U9.12 (CS), Y1.1 (EN), Y1.4 (Vdd)
+BATT: C12.1, R13.1, R18.1, TP2.1 (1_1), U1.2 (BAT), U1.3 (BAT)
/3V3_ANA_IN: C19.1, FB1.2, U5.1 (IN), U5.3 (EN)
/3V3_MIC: C38.1, C39.1, C40.1, FB2.2, MK1.2 (VDD), MK2.2 (VDD), MK2.4 (SELECT), MK3.2 (VDD)
/BB_EN: D4.3, R20.2, U3.6 (EN)
/ESP_EN: C22.2, R4.1, TP9.1 (1_1), U2.3 (EN)
/HPL_N: J5.2, TP21.1 (1_1), U8.20 (HPLCOM)
/HPL_P: J5.1, TP20.1 (1_1), U8.19 (HPLOUT)
/HPR_N: J3.5, TP23.1 (1_1), U8.22 (HPRCOM)
/HPR_P: J3.4, TP22.1 (1_1), U8.23 (HPROUT)
/MIC_JACK_T: C35.2, C36.2, D6.1 (A1), J4.T, R36.2
/SW_L1: L1.1, U3.4 (L1)
/SW_L2: L1.2, U3.2 (L2)
/USB_C_DN: J1.A7 (D-), J1.B7 (D-), U7.6 (I/O1)
/USB_C_DP: J1.A6 (D+), J1.B6 (D+), U7.4 (I/O2)
/VBAT_CONN: J3.1, R18.2
/VINA: C13.2, R26.1, U3.8 (VINA)
BAT_ADC: C21.1, R13.2, R27.1, U2.39 (IO1)
BAT_TEMP: J3.2, R15.1, U1.1 (TS)
BTN_MFB: C45.2, R40.2, SW4.2, U2.35 (IO42)
BTN_PWR: Q1.3 (D), R23.2, U2.34 (IO41)
BTN_WHEEL: C46.2, R45.2, SW3.S, TP11.1 (1_1), U2.25 (IO48)
CODEC_RST: R10.1, U2.18 (IO10), U8.31 (~RESET)
ENC_A: C43.2, R38.2, SW3.A, U2.21 (IO13)
ENC_B: C44.2, R39.2, SW3.B, U2.22 (IO14)
GND: C7.2, C8.2, C9.2, C11.2, C12.2, C13.1, C14.1, C15.1, C16.1, C17.1, C18.1, C19.2, C20.1, C21.2, C22.1, C23.2, C24.2, C25.2, C26.1, C27.2, C28.2, C29.2, C30.2, C31.2, C32.2, C33.2, C34.2, C36.1, C37.2, C38.2, C39.2, C40.2, C41.2, C42.2, C43.1, C44.1, C45.1, C46.1, D1.2 (A2), D5.2 (A2), D6.2 (A2), J1.A1 (GND), J1.A12 (GND), J1.B1 (GND), J1.B12 (GND), J3.3, J3.MP (MountPin), J4.R, J4.S, MK1.4 (SELECT), MK1.5 (GND), MK2.5 (GND), MK3.4 (SELECT), MK3.5 (GND), Q1.2 (S), R1.1, R2.1, R3.1, R10.2, R11.1, R12.1, R15.2, R19.1, R20.1, R22.1, R25.2, R27.2, SW2.1, SW3.1 (EH), SW3.2 (EH), SW3.3 (EH), SW3.4 (EH), SW3.5 (EH), SW3.6 (EH), SW3.C, SW4.1, TP8.1 (1_1), TP16.1 (1_1), U1.4 (~CE), U1.5 (EN2), U1.8 (VSS), U1.17 (VSS), U2.1 (GND), U2.40 (GND), U2.41 (GND), U3.3 (PGND), U3.9 (GND), U3.11 (PGND), U4.2 (GND), U5.2 (GND), U7.2 (GND), U8.6 (DVSS), U8.17 (AVSS1), U8.21 (DRVSS), U8.26 (AVSS2), U8.33 (EP), U9.1 (SDO/SA0), U9.2 (SDX), U9.3 (SCX), U9.6 (GND), U9.7 (GND), Y1.2 (GND)
I2C_SCL: R6.2, U2.17 (IO9), U8.8 (SCL), U9.13 (SCL)
I2C_SDA: R5.2, U2.12 (IO8), U8.9 (SDA), U9.14 (SDA)
I2S_BCLK: R29.2, U8.2 (BCLK)
I2S_DIN: R35.2, U8.5 (DOUT)
I2S_DOUT: R31.2, U8.4 (DIN)
I2S_MCLK: R28.2, R33.2
I2S_WS: R30.2, U8.3 (WCLK)
IMU_INT: U2.19 (IO11), U9.4 (INT1)
IO_CHG: D3.1 (K), U1.9 (~CHG)
IO_PGOOD: R14.2, U1.7 (~PGOOD), U2.24 (IO47)
JACK_DET: D5.1 (A1), J4.RN, R37.2, U2.20 (IO12)
LED_B: R43.1, U2.33 (IO40)
LED_G: R42.1, U2.32 (IO39)
LED_R: R41.1, U2.31 (IO38)
MICBIAS: C37.1, R36.1, TP19.1 (1_1), U8.15 (MICBIAS)
MIC_IN: C35.1, U8.10 (MIC1LP/LINE1LP)
unnamed: D3.2 (A), R17.1
unnamed: D4.1, R19.2, R21.2, SW1.2
unnamed: D7.2 (BK), R43.2
unnamed: D7.4 (GK), R42.2
unnamed: D7.3 (RK), R41.2
unnamed: J1.A5 (CC1), R1.2
unnamed: J1.B5 (CC2), R2.2
unnamed: C9.1, J1.SH (SHIELD), R3.2
unnamed: Q1.1 (G), R21.1
unnamed: R16.2, U1.6 (EN1)
unnamed: R11.2, U1.12 (ILIM)
unnamed: R12.2, U1.16 (ISET)
unnamed: R8.2, SW2.2, TP10.1 (1_1), U2.27 (IO0)
unnamed: TP14.1 (1_1), U2.38 (IO2)
unnamed: R28.1, U2.4 (IO4)
unnamed: R29.1, U2.5 (IO5)
unnamed: R30.1, U2.6 (IO6)
unnamed: R31.1, U2.7 (IO7)
unnamed: R35.1, U2.8 (IO15)
unnamed: R32.1, U2.9 (IO16)
unnamed: TP13.1 (1_1), U2.36 (RXD0)
unnamed: TP12.1 (1_1), U2.37 (TXD0)
unnamed: R24.1, R25.1, U3.7 (PS/SYNC)
unnamed: R33.1, R34.2, U8.1 (MCLK)
unnamed: R34.1, Y1.3 (OUT)
PDM_CLK: MK1.3 (CLOCK), MK2.3 (CLOCK), MK3.3 (CLOCK), R32.2
PDM_DIN0: MK1.1 (DATA), MK2.1 (DATA), U2.10 (IO17)
PDM_DIN1: MK3.1 (DATA), U2.11 (IO18)
PWR_HOLD: D4.2, R22.2, U2.23 (IO21)
USB_DN: TP17.1 (1_1), U2.13 (USB_D-), U7.1 (I/O1)
USB_DP: TP18.1 (1_1), U2.14 (USB_D+), U7.3 (I/O2)
VBUS: C7.1, C8.1, D1.1 (A1), J1.A4 (VBUS), J1.A9 (VBUS), J1.B4 (VBUS), J1.B9 (VBUS), TP1.1 (1_1), U1.13 (IN), U7.5 (VBUS)
VSYS: C11.1, C14.2, R16.1, R17.2, R24.2, R26.2, SW1.1, TP3.1 (1_1), U1.10 (OUT), U1.11 (OUT), U3.5 (VIN)

Notes on the sheet:
1.8V LDO
3.0V LDO
Battery Capacity Measurement
3.3 V buck-boost TPS63001
Soft Power Latch
Controls
BATTERY SM03B-SRSS-TB
Iin(ILIM mode) = 1550/R = ~1 A
Battery Port
IMU
Microcontroller
Audio Codec (MIC & Speaker)
PDM microphones
TMR keep floating for default safety timer
Status LED
Battery Management
USB TypeC 16Pins 8mm
SPK RIGHT SM02B-SRSS-G-TB

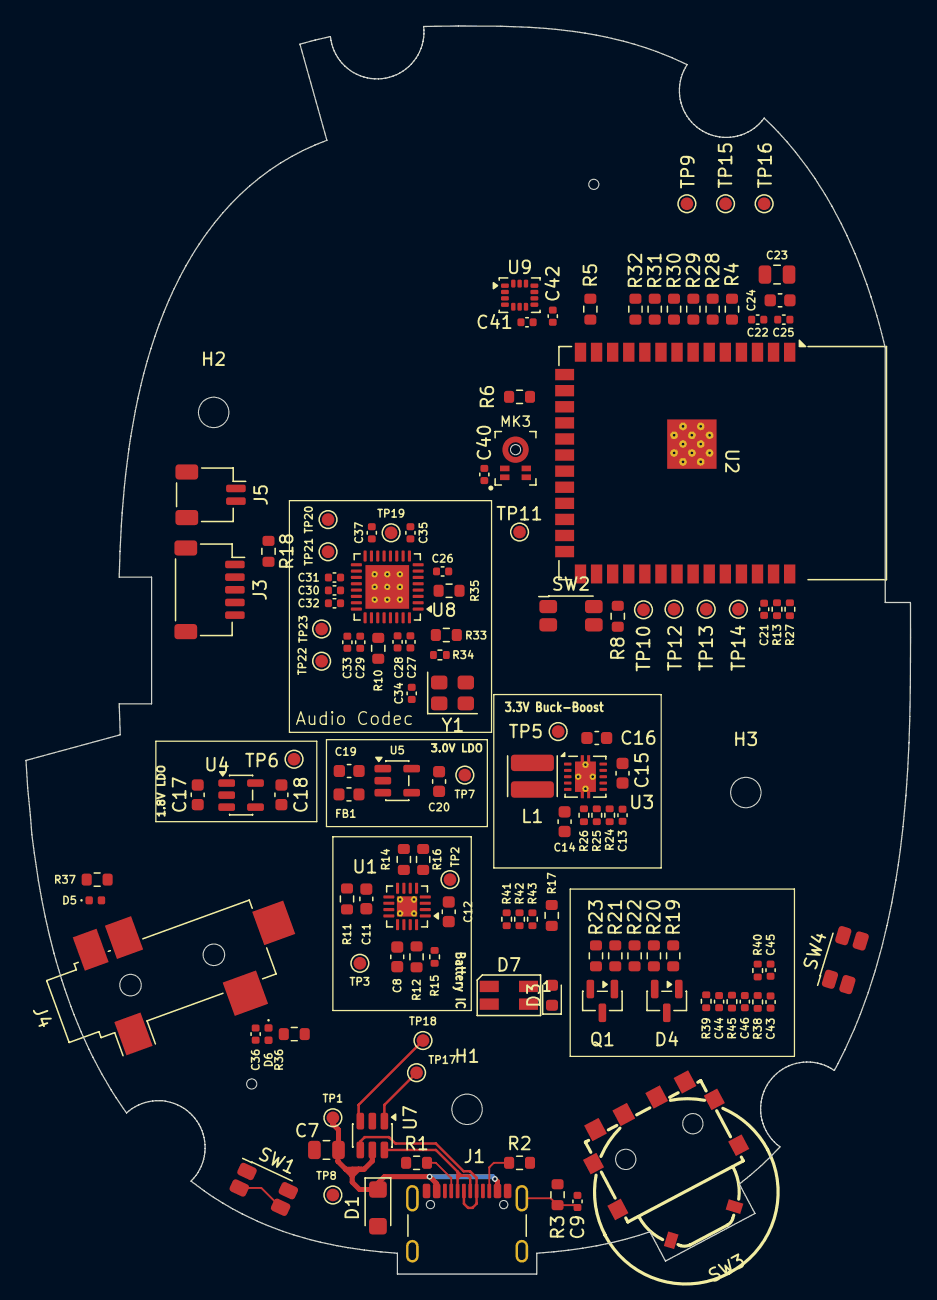
[picture p28: board headset-orga.kicad_pcb from above]

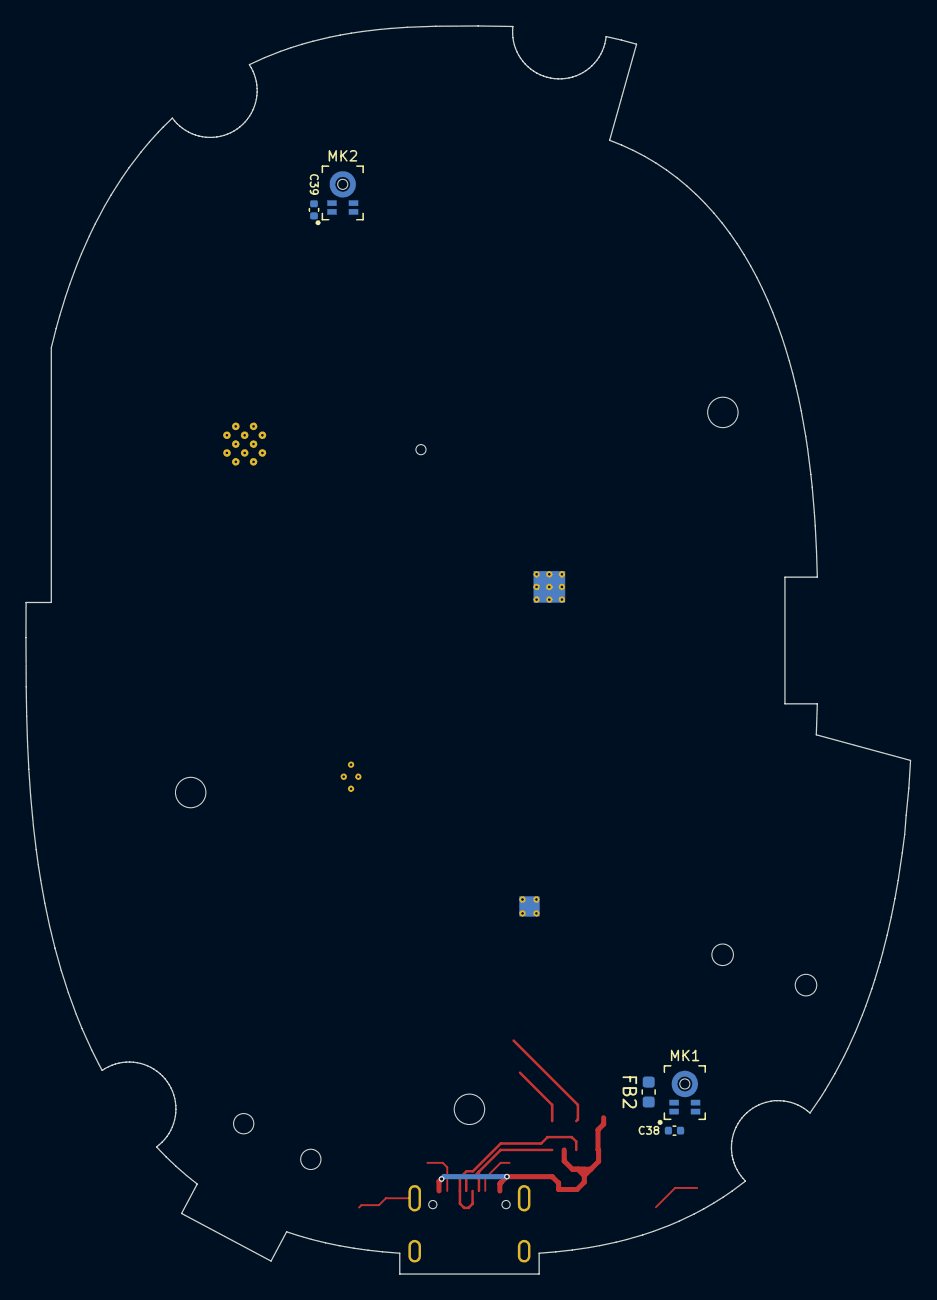
[picture p29: board headset-orga.kicad_pcb from below]

Board: 4 copper layers, 69.8 x 98.5 mm, 136 parts (5 on the bottom side), 77 nets.
